CoyBeard/Mirobot-Frame-Building-Cell/CAD/Gantry System/Photos/With Monitor Setup.JPG

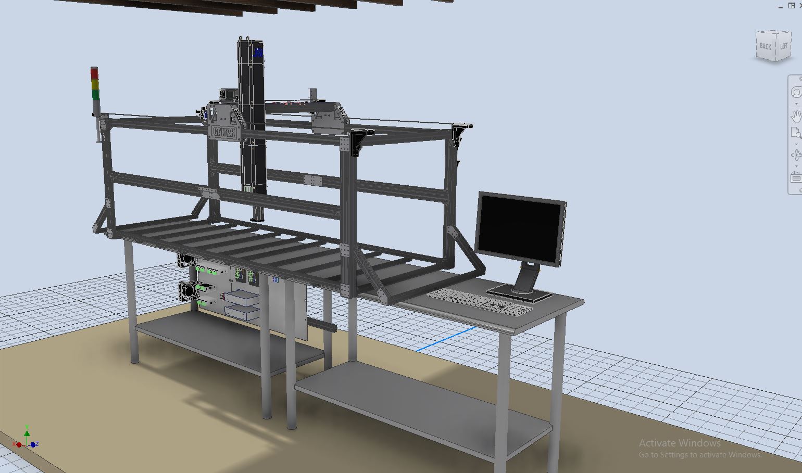
CAD/Gantry System/Photos/With Monitor Setup.JPG
