CoyBeard/Mirobot-Frame-Building-Cell/README.md

# Mirobot-Frame-Building-Cell

This is the posted CAD and Code from my video on youtube:
