CoyBeard/Mirobot-Frame-Building-Cell/CAD/Gantry System/Controllers/8x-relay-module-138x50-1.snapshot.8/8_Channel_Relay_Module_138_x_50_R2.png

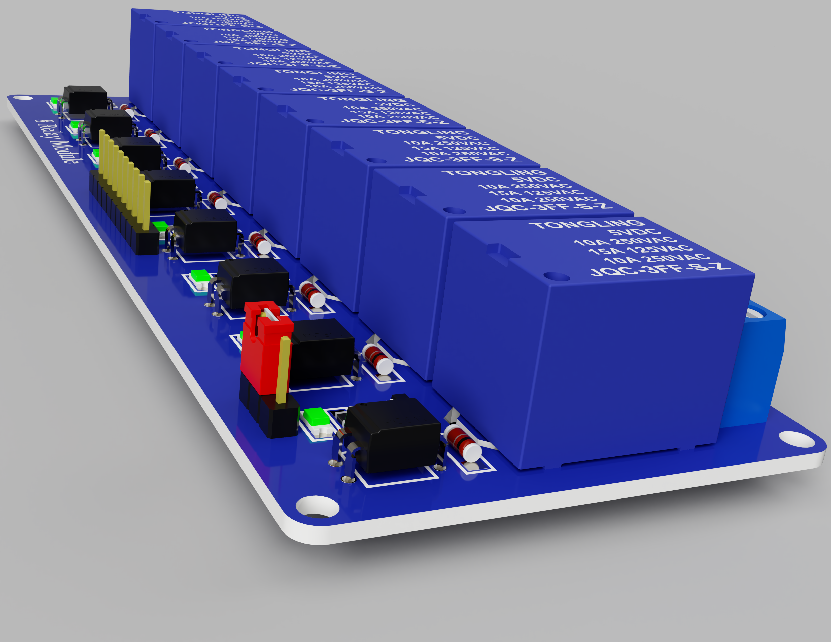
CAD/Gantry System/Controllers/8x-relay-module-138x50-1.snapshot.8/8_Channel_Relay_Module_138_x_50_R2.png
