CoyBeard/Mirobot-Frame-Building-Cell/CAD/Gantry System/DELL 1909Wf Monitor/RENDERY/2.png

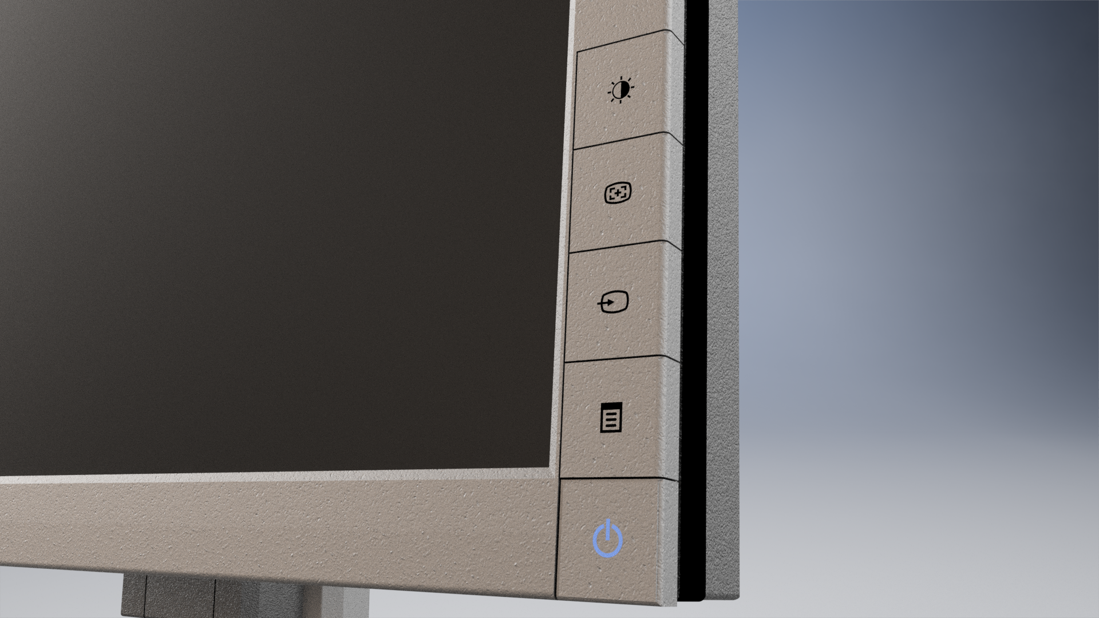
CAD/Gantry System/DELL 1909Wf Monitor/RENDERY/2.png
