CoyBeard/Mirobot-Frame-Building-Cell/CAD/Gantry System/Electrical/BTT Octopus V1.0 Pinout.png

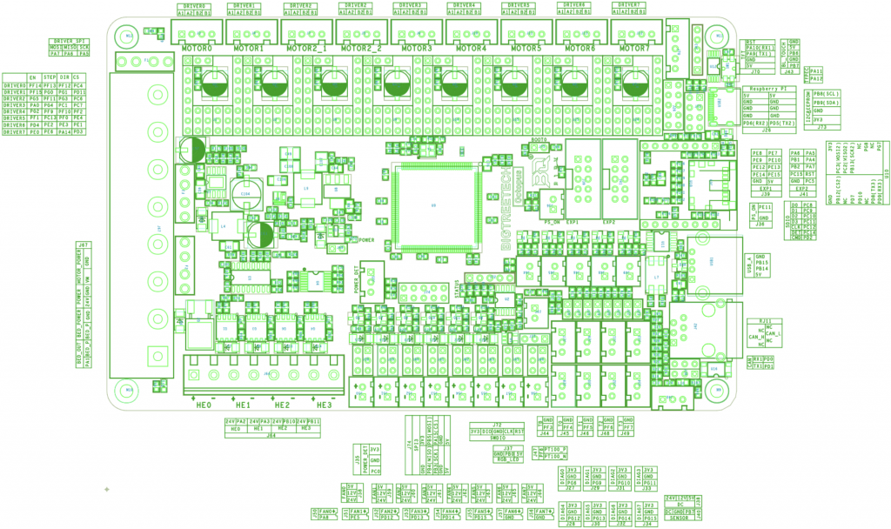
CAD/Gantry System/Electrical/BTT Octopus V1.0 Pinout.png
