CoyBeard/Mirobot-Frame-Building-Cell/CAD/Gantry System/Photos/Capture.JPG

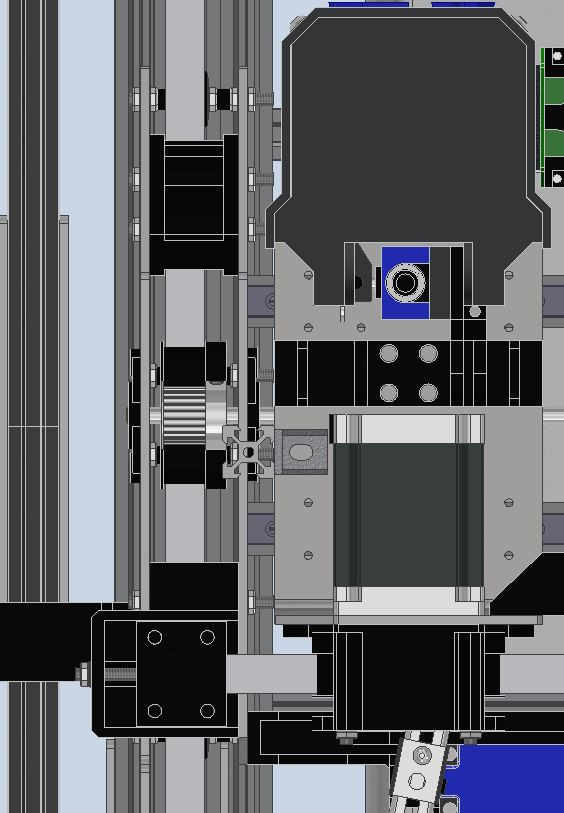
CAD/Gantry System/Photos/Capture.JPG
