CoyBeard/Mirobot-Frame-Building-Cell/CAD/Gantry System/Photos/Protoype.JPG

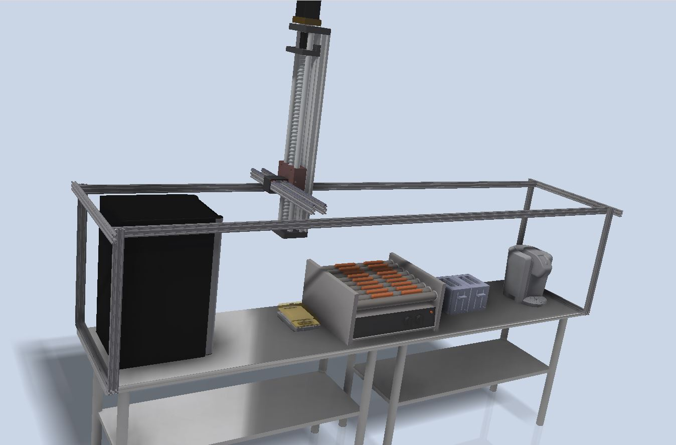
CAD/Gantry System/Photos/Protoype.JPG
