CoyBeard/Mirobot-Frame-Building-Cell/CAD/Gantry System/Photos/V1 CAD With Ray Tracing5.JPG

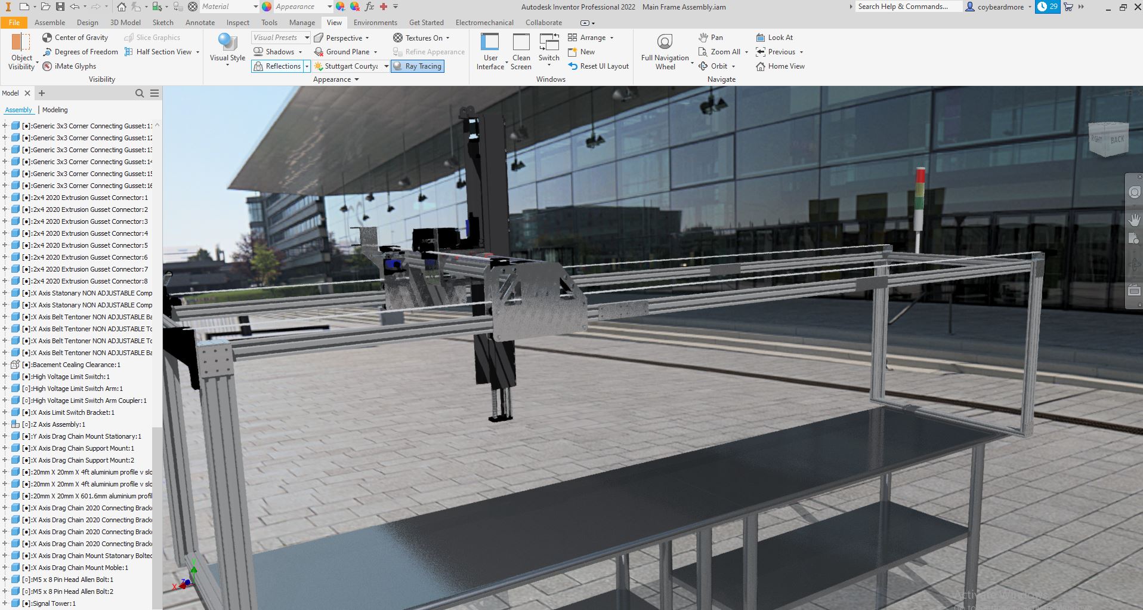
CAD/Gantry System/Photos/V1 CAD With Ray Tracing5.JPG
