CoyBeard/Mirobot-Frame-Building-Cell/CAD/Gantry System/Photos/V1 CAD With Ray Tracing6.JPG

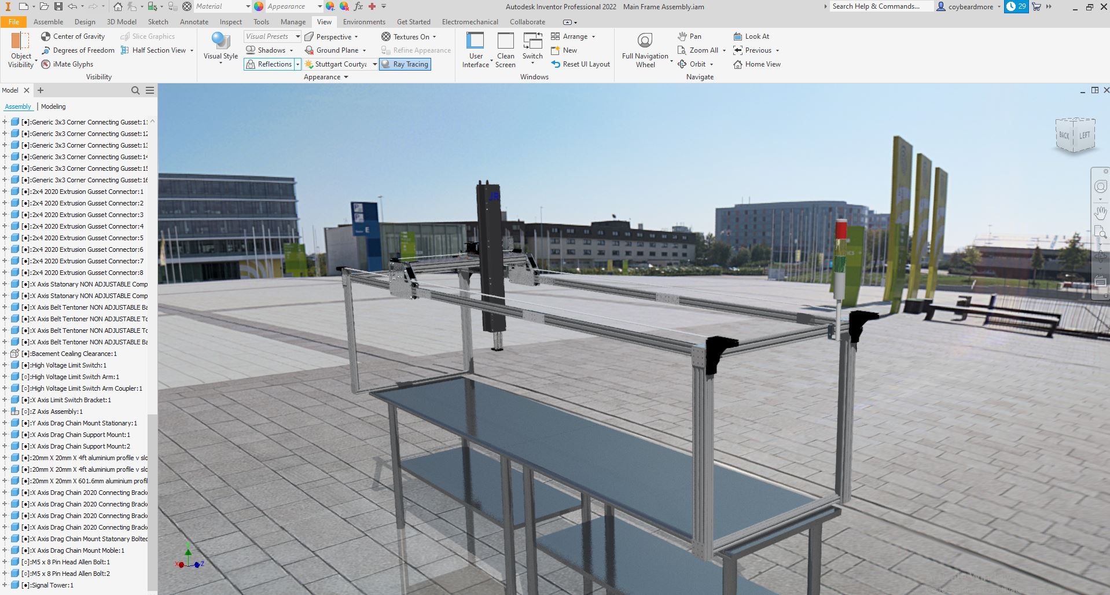
CAD/Gantry System/Photos/V1 CAD With Ray Tracing6.JPG
