CoyBeard/Mirobot-Frame-Building-Cell/CAD/Gantry System/Photos/V1 CAD With Ray Tracing.JPG

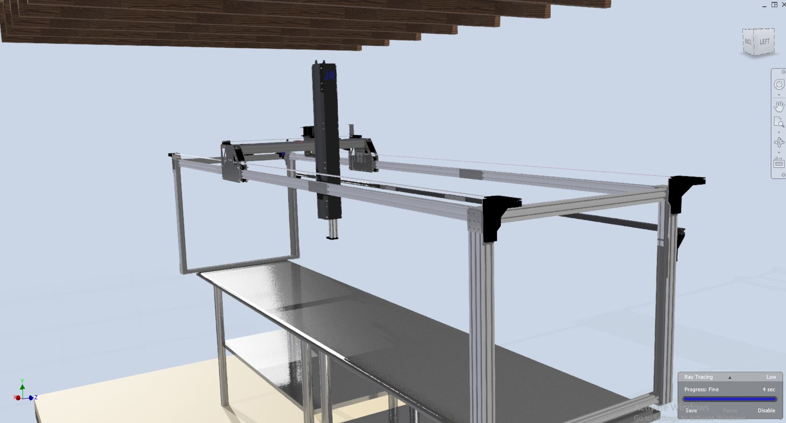
CAD/Gantry System/Photos/V1 CAD With Ray Tracing.JPG
