CoyBeard/Mirobot-Frame-Building-Cell/CAD/Gantry System/Photos/With Controll Pannel 2.JPG

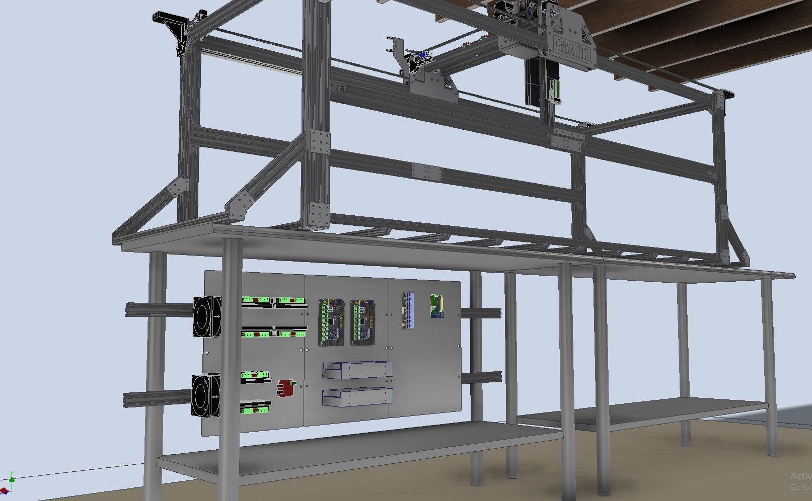
CAD/Gantry System/Photos/With Controll Pannel 2.JPG
