CoyBeard/Mirobot-Frame-Building-Cell/CAD/Gantry System/Photos/With Controll Pannel.JPG

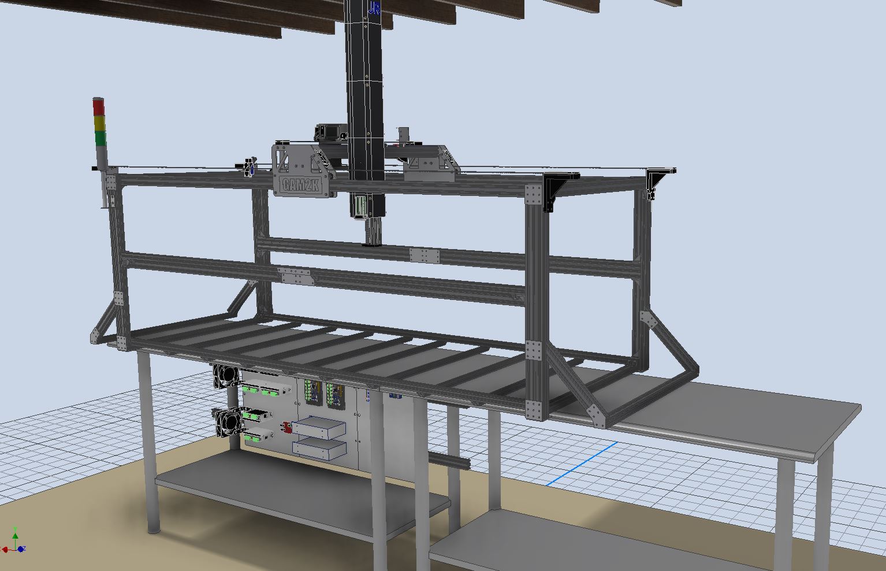
CAD/Gantry System/Photos/With Controll Pannel.JPG
