CoyBeard/Mirobot-Frame-Building-Cell/CAD/Gantry System/Photos/Z Axis Housing Dimentions.JPG

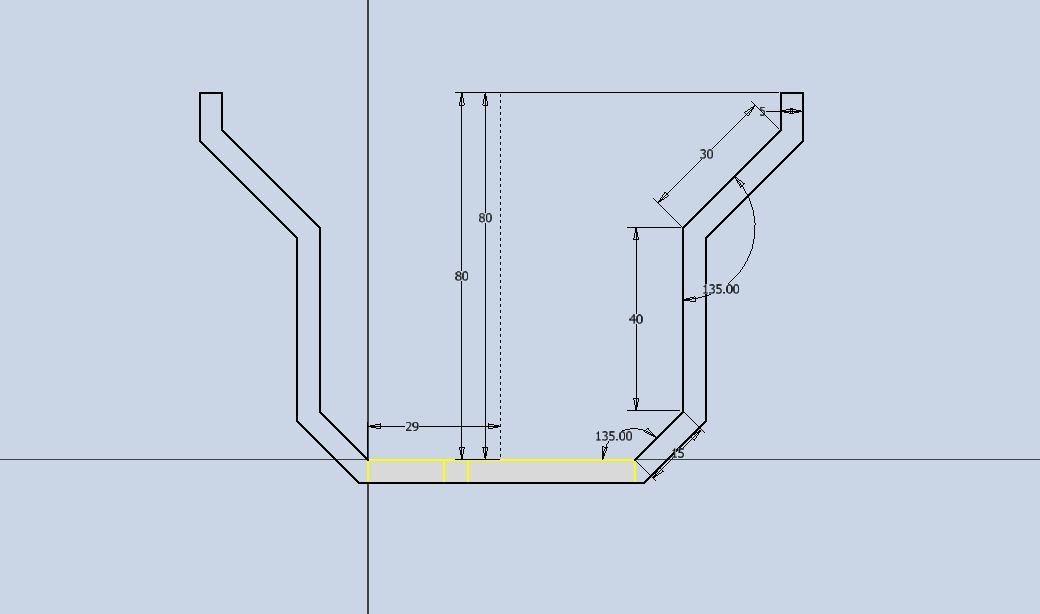
CAD/Gantry System/Photos/Z Axis Housing Dimentions.JPG
