CoyBeard/Mirobot-Frame-Building-Cell/CAD/Mirobot Rep Model/6 Axis Robot-ABB6650-3.jpg

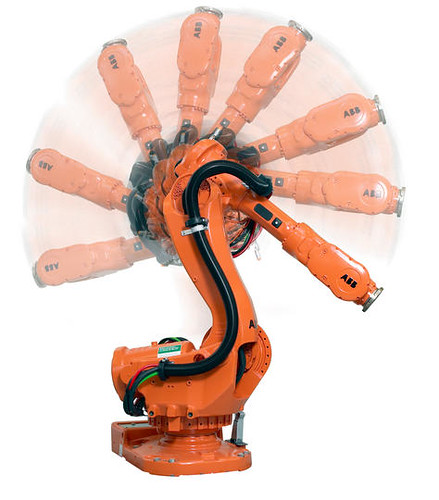
CAD/Mirobot Rep Model/6 Axis Robot-ABB6650-3.jpg
