CoyBeard/Mirobot-Frame-Building-Cell/CAD/Mirobot Rep Model/6 Axis Robot-ABB6650-4.jpg

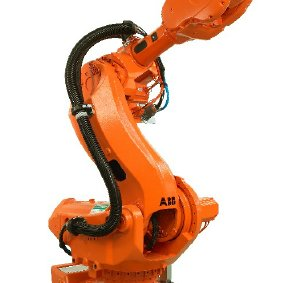
CAD/Mirobot Rep Model/6 Axis Robot-ABB6650-4.jpg
