CoyBeard/Mirobot-Frame-Building-Cell/Code/VSCode/Demo Program UI.JPG

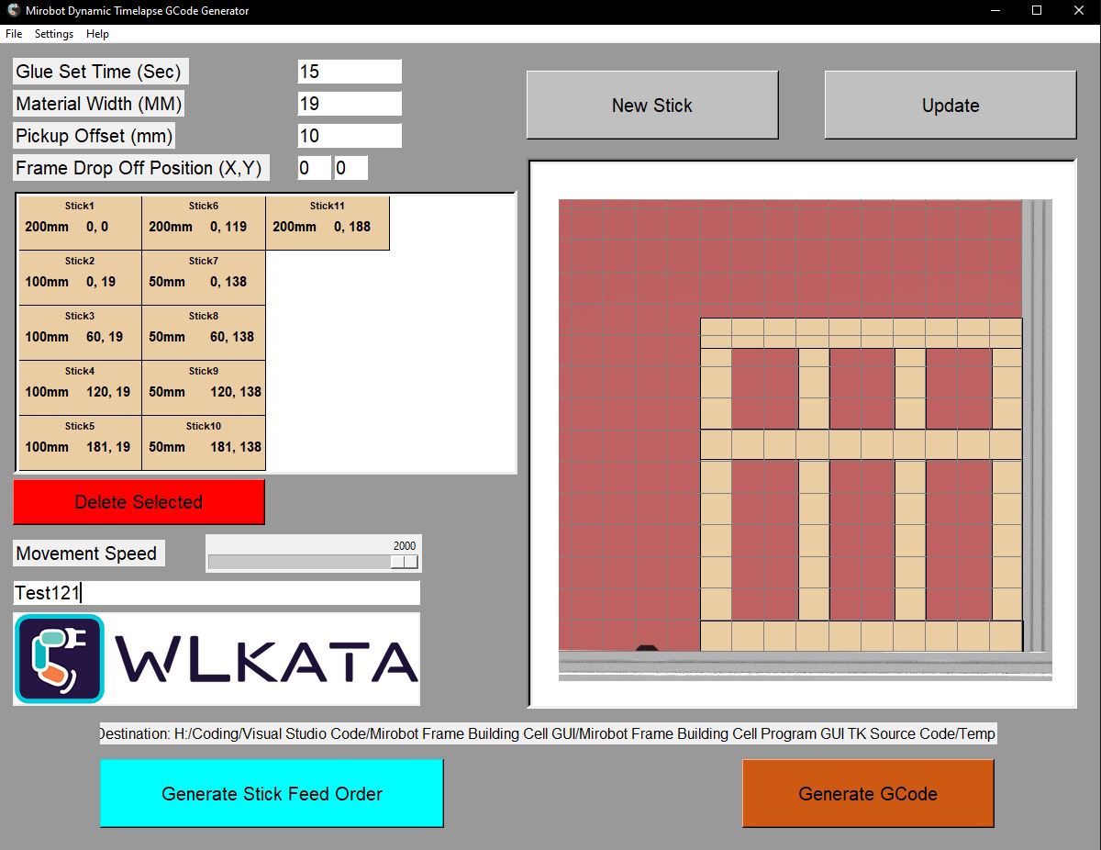
Code/VSCode/Demo Program UI.JPG
