CoyBeard/Mirobot-Frame-Building-Cell/CAD/Gantry System/Machined Parts/V1 Machined Parts List.txt

1x  4in x 6in Steel Rectangular Tubing 4in long Machined
1x  X Axis Belt Motor Inside Frame Machined
1x  X Axis Belt V Wheel and Motor Frame Machined
1x  X Axis Belt V Wheel Frame Machined
1x  X Axis Belt V Wheel LEFT Outside Frame Machined
1x  X Axis Belt V Wheel RIGHT Outside Frame Machined
2x  2x4 2020 Extrusion Gusset Connector
2x  X Axis Statonary Composite Belt Holder
2x  X Axis Statonary NON ADJUSTABLE Composite Belt Holder
4x  X Axis Drag Chain 2020 Connecting Bracket
16x Generic 3x3 Corner Connecting Gusset
