CoyBeard/Mirobot-Frame-Building-Cell/Code/VSCode/Mirobot Frame Building Cell Program GUI TK Source Code V1.1/Temp Files/TestTw Stick Feed Order.txt

;File generated by Mirobot Frame Building Cell GUI
;V1.0.0
;Date Generated: 2023-01-07 21:08:34.981438

Universal Information:
Material Width: 19
Build Platform Width: 280mm
Build Platform Heighth: 275mm

Stick Feed Order:
1.  Stick1, Length: 200mm

2.  Right Wall, Length: 100mm

3.  Stick3, Length: 100mm

4.  Stick4, Length: 200mm

End
