CoyBeard/Mirobot-Frame-Building-Cell/CAD/Gantry System/Machined Parts/Machined Parts Tracking.pdf

| GAM2K Machined Parts List

PROJECT TITLE

GAM2K | COMPANY NAME JR Automation
PROJECT MANAGER | Coy Beardmore DATE 10/30/21
PROJECT DETAILS | COST/HOURS
STATUS | PRIORITY | START DATE | END DATE | DURATION | ASSIGNEE | DESCRIPTION | FIXED COST | HOURS

## 1x 4in x 6in Steel Rectangular Tubing 4in long

3D Modeled | | 10/11/21 | 10/30/21 | 19 | CJB | Create CAD Model of Part
CAM Generated | | | | | CJB | Generate GCode for CNC Mill
Machined | | | | | CJB | Part Manufactured
Installed | | | | | CJB | Part Installed

## 1x X Axis Belt Motor Inside Frame

3D Modeled | | 10/11/21 | 10/30/21 | 19 | CJB | Create CAD Model of Part
CAM Generated | | | | | CJB | Generate GCode for CNC Mill
Machined | | | | | CJB | Part Manufactured
Installed | | | | | CJB | Part Installed

## 1x X Axis Belt V Wheel and Motor Frame

3D Modeled | | 10/11/21 | 10/30/21 | 19 | CJB | Create CAD Model of Part
CAM Generated | | | | | CJB | Generate GCode for CNC Mill
Machined | | | | | CJB | Part Manufactured
Installed | | | | | CJB | Part Installed

## 1x X Axis Belt V Wheel Frame

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

## 1x X Axis Belt V Wheel LEFT Outside Frame

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

STATUS KEY | PRIORITY KEY
3D Modeled | Low
CAM Generated | Medium
Machined | High

Installed

## 1x X Axis Belt V Wheel RIGHT Outside Frame

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

## 2x 2x4 2020 Extrusion Gusset Connector

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

## 2x X Axis Statonary Composite Belt Holder

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

## 2x X Axis Statonary NON ADJUSTABLE Composite Belt Holder

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

## 4x X Axis Drag Chain 2020 Connecting Bracket

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

## 16x Generic 3x3 Corner Connecting Gusset

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
