CoyBeard/Mirobot-Frame-Building-Cell/CAD/Gantry System/3D Printed Parts/Printed Parts Tracking.pdf

| GAM2K 3D PRINTED PARTS LIST

PROJECT TITLE

GAM2K | COMPANY NAME JR Automation
PROJECT MANAGER | Coy Beardmore DATE 10/30/21
| | | | PROJECT DETAILS | | | | COST/HOURS
STATUS | PRIORITY | START DATE | END DATE | DURATION | ASSIGNEE | DESCRIPTION | FIXED COST | Printed | Time Elapsed

## BK1XO1 X Axis Pully Support

Modeled | | 10/11/21 | 10/30/21 | 19 | CJB | Create CAD Model of Part
Sliced | 10/30/21 | 10/30/21 | 0 | CJB | Slice Model into GCode
Printed | | 10/30/21 | | | CJB | 3D Print Model to Spec
Installed | CJB | Install Part

## BK1XO1 Y Axis Limit Switch and Drag Chain Mount

Modeled | | 10/11/21 | 10/30/21 | 19 | CJB | Create CAD Model of Part
Sliced 10/30/21 10/30/21 0 Printed 10/30/21 Installed | CJB CJB CJB | Slice Model into GCode 3D Print Model to Spec Install Part
| BK1XO3 Z Axis Cover Frame
Modeled | 10/11/21 | 10/30/21 | 19 | CJB | Create CAD Model of Part
Sliced | 10/30/21 | 10/30/21 | 0 | CJB | Slice Model into GCode
Printed | 10/30/21 | | | CJB | 3D Print Model to Spec
Installed | | | | CJB | Install Part

## BK2XO2 X Axis Belt Tentoner Base and Mirrored

Modeled | 10/11/21 | 10/30/21 | 19 | CJB | Create CAD Model of Part
Sliced | 10/30/21 | 10/30/21 | 0 | CJB | Slice Model into GCode
Printed | 10/30/21 | | | CJB | 3D Print Model to Spec
Installed | | | | CJB | Install Part

## BK2XO2 X Axis Belt Tentoner Stationary Base and Mirrored

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

STATUS KEY | PRIORITY KEY
Modeled | Low
Sliced | Medium
Printed | High

Installed

## BK2XO2 X Axis Drag Chain Support Mount

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

## BK5XO5 GAM2K Parts 02

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

## BK6XO6 8mm ID 15mm Deep Idler Pully

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

## BK8XO8 GAM2K Parts 03

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

## BK9XO9 GAM2K Parts 01

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

## BK24XO24 Spacers

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

## BL1XO1 JR Logo Text

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

## GY1XO1 Z Axis Cover Bottom

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

## GY1XO1 Z Axis Cover Top

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

## GY1XO1 Z Axis Frame Top

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

## GY1XO3 Z Axis Cover

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
