CoyBeard/Mirobot-Frame-Building-Cell/CAD/Conveyor Belt/Conveyor Belt Assembly.stp

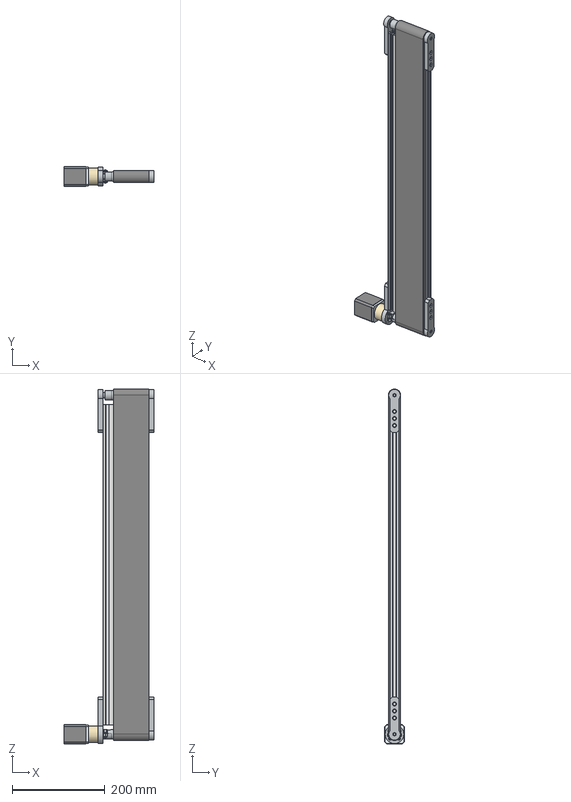
[picture p29: CAD file, 2023-06-10]
CAD/Conveyor Belt/Conveyor Belt Assembly.stp
193.3 x 42.0 x 764.4 mm
20100 640mm Aluminum Extrusion
Roller Bracket x 3
5mm ID 8mm OD 2.5mm Deep Roller Bearing x 3
Roller Bracket Driven
M5 120mm Rod
M5 60mm Rod
M5 5mm Spacer x 3
Driven Pully
Driven Pully Coupler Top
M4 x 12 Socket Head Bolt x 2
M4 Nut x 2
Idler Pully
Belt 5ft x 3in
Nema 17 5TO1 Geared Stepper Motor
