CoyBeard/Mirobot-Frame-Building-Cell/CAD/Glue Extruder/3ml/3ml Glue Extruder Assembly.stp

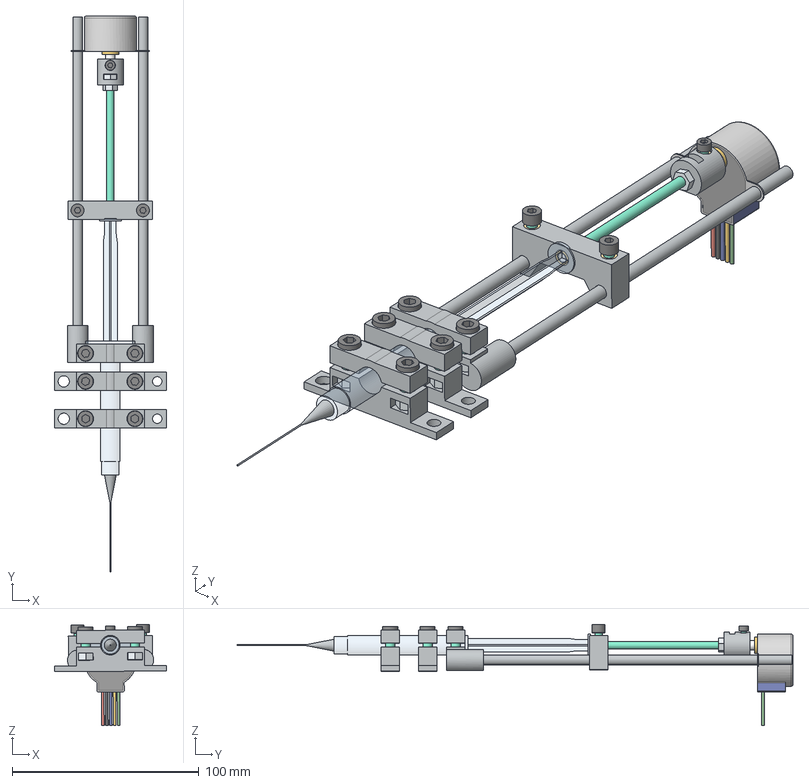
[picture p30: CAD file, 2023-06-10]
CAD/Glue Extruder/3ml/3ml Glue Extruder Assembly.stp
60.0 x 297.5 x 54.1 mm
3ml Main Clamp Top x 3
3ml Seringe Press
3ml Seringe Main
M3 6mm Socket Head Bolt
3ml Main Clamp Bottom
M5 Nut x 6
Needle
M5 12mm Socket Head Bolt x 6
M3 5mm OD 4mm Deep Threaded Insert
5V Stepper Motor
5V Stepper Motor Coupler to M4 Threaded Rod
Stationary Thread Holding Block
M4 6mm OD 10mm Deep Threaded Insert x 3
M4 12mm Socket Head Bolt x 2
3ml Mount Clamp x 2
M4 Nut x 2
M4 80mm Threaded Rod
M5 175mm Rod x 2
