CoyBeard/Mirobot-Frame-Building-Cell/CAD/Glue Extruder/5ml/5ml Glue Extruder Assembly.stp

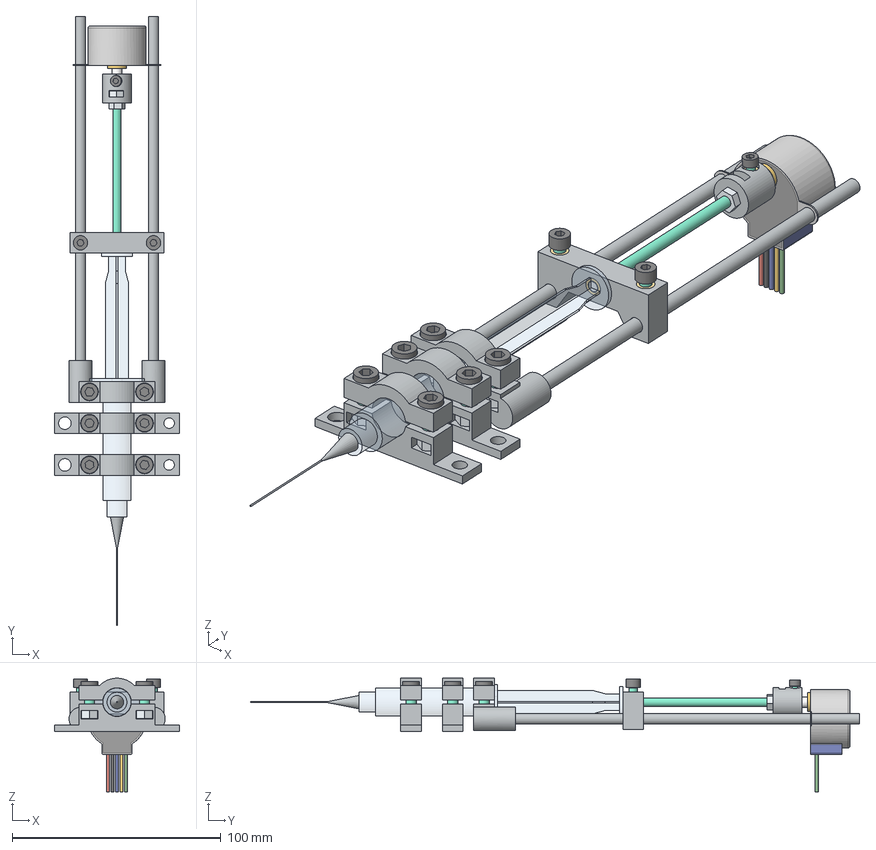
[picture p31: CAD file, 2023-06-10]
CAD/Glue Extruder/5ml/5ml Glue Extruder Assembly.stp
60.0 x 292.0 x 54.5 mm
5ml Seringe Press
5ml Seringe Main
5ml Main Clamp Bottom
5ml Mount Clamp x 2
M5 Nut x 6
5ml Main Clamp Top x 3
M5 12mm Socket Head Bolt x 6
Needle
M5 175mm Rod x 2
Stationary Thread Holding Block
M4 6mm OD 10mm Deep Threaded Insert x 3
M4 12mm Socket Head Bolt x 2
5V Stepper Motor
M4 80mm Threaded Rod
5V Stepper Motor Coupler to M4 Threaded Rod
M4 Nut x 2
M3 5mm OD 4mm Deep Threaded Insert
M3 6mm Socket Head Bolt
