CoyBeard/Mirobot-Frame-Building-Cell/CAD/Gantry System/3D Printed Parts/Raspberry Pi 4B Case/Pi4caseTop.stl

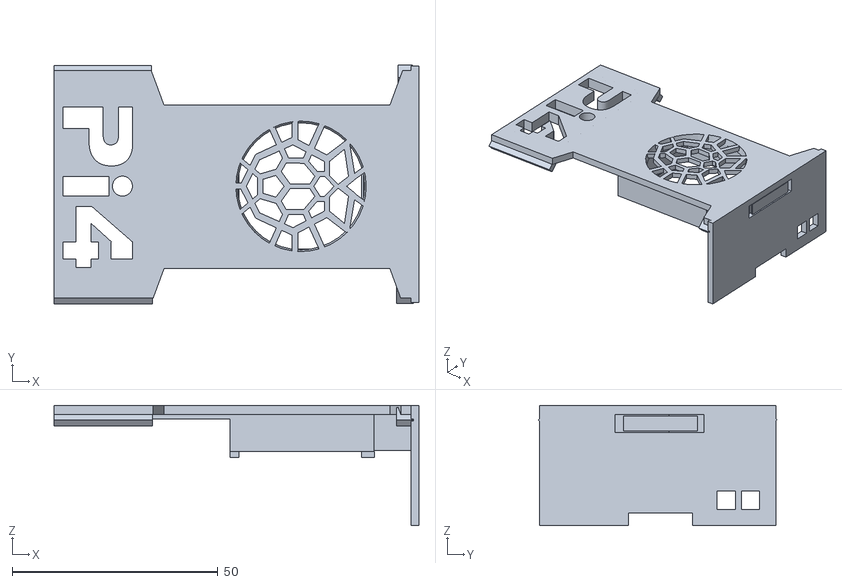
[picture p32: CAD file, 2023-06-10]
CAD/Gantry System/3D Printed Parts/Raspberry Pi 4B Case/Pi4caseTop.stl
88.8 x 58.1 x 29.2
