CoyBeard/Mirobot-Frame-Building-Cell/CAD/Gantry System/3D Printed Parts/STLs/V1/Black PLA/1x  Z Axis Cover Frame Bottom.stl

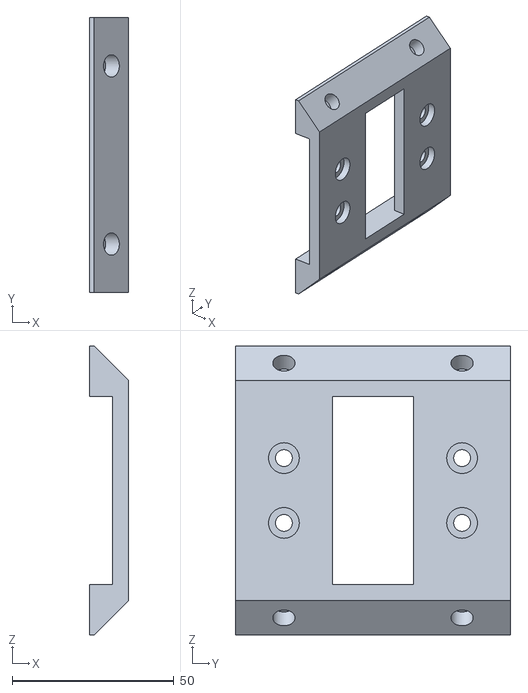
[picture p33: CAD file, 2023-06-10]
CAD/Gantry System/3D Printed Parts/STLs/V1/Black PLA/1x Z Axis Cover Frame Bottom.stl
12.1 x 85.0 x 89.2
