CoyBeard/Mirobot-Frame-Building-Cell/CAD/Gantry System/Drivers/DM542/DM542.STEP

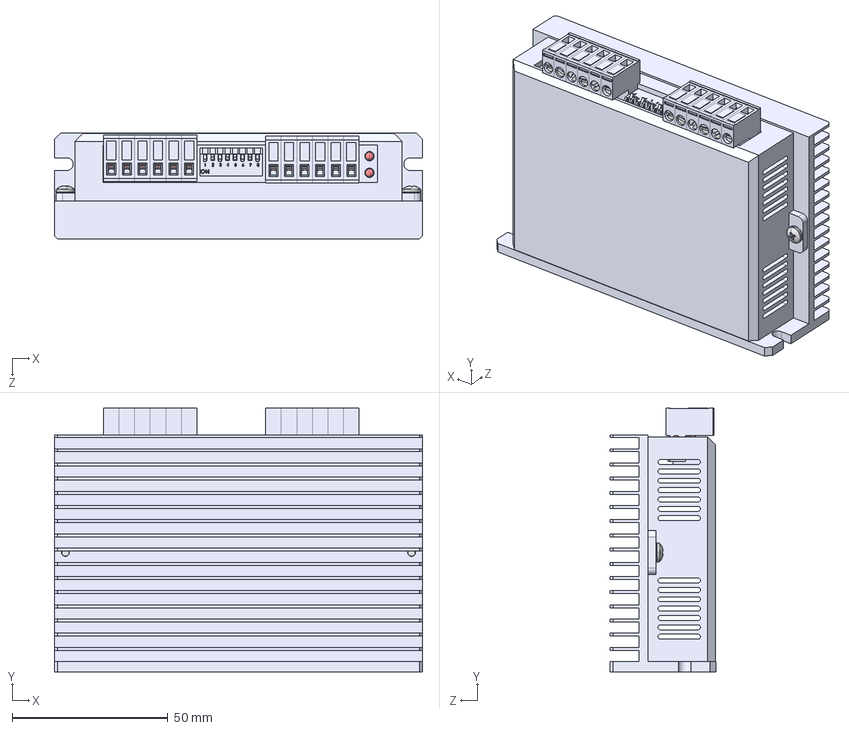
[picture p34: CAD file, 2023-06-10]
CAD/Gantry System/Drivers/DM542/DM542.STEP
118.0 x 84.6 x 34.0 mm
散熱片
外殼
Pan Head M3x5_96741A118 x 2
端子(1P) x 12
ｩTｩwﾁｳｵｷ x 12
緊迫 x 12
LED x 2
DIP Switch
Switch x 8
