CoyBeard/Mirobot-Frame-Building-Cell/CAD/Gantry System/Machined Parts/Y Axis Frame HAAS Files/4in x 6in Steel Rectangular Tubing 4in long Machined.stp

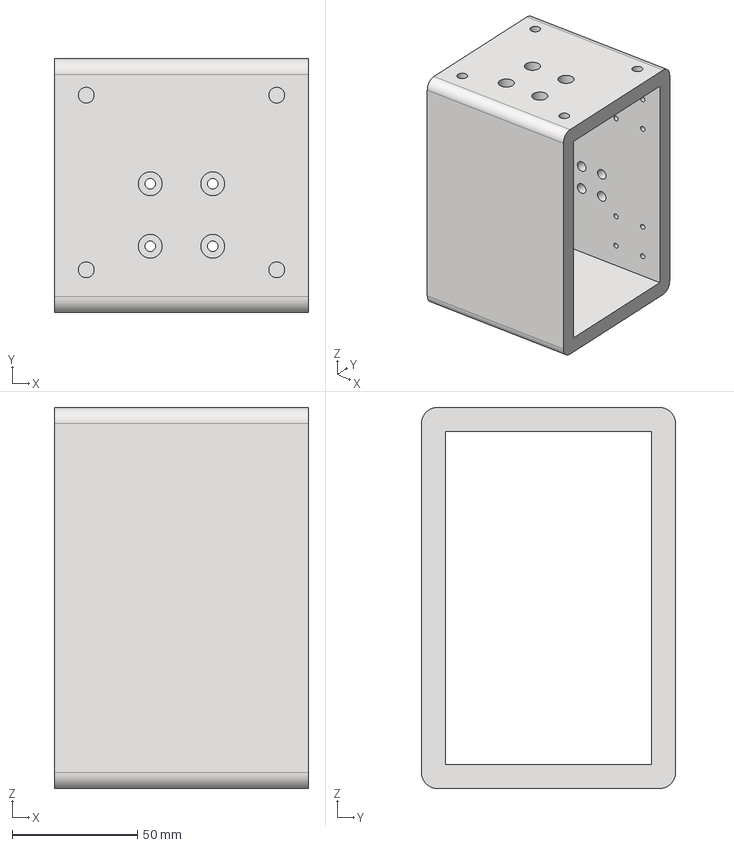
[picture p35: CAD file, 2023-06-10]
CAD/Gantry System/Machined Parts/Y Axis Frame HAAS Files/4in x 6in Steel Rectangular Tubing 4in long Machined.stp
101.6 x 101.6 x 152.4 mm
