CoyBeard/Mirobot-Frame-Building-Cell/CAD/Gantry System/Power Supplys/24V15A power supply.stp

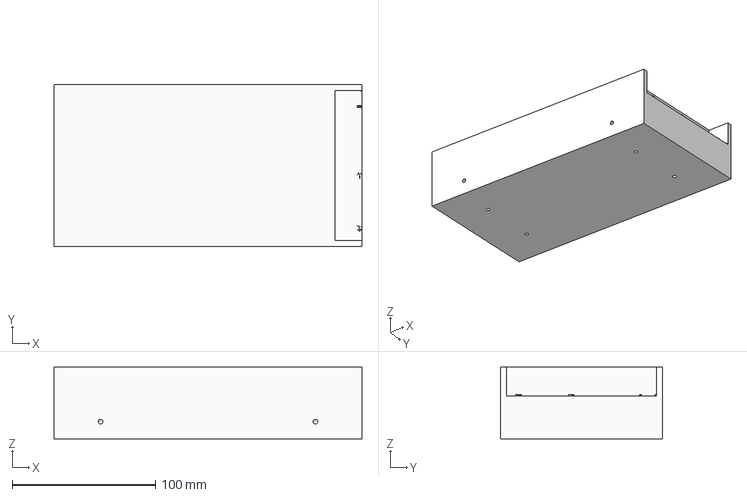
[picture p36: CAD file, 2023-06-10]
CAD/Gantry System/Power Supplys/24V15A power supply.stp
215.0 x 113.0 x 50.0 mm
