CoyBeard/Mirobot-Frame-Building-Cell/CAD/Mirobot Rep Model/Sliding Rail/Floor Mounting Plate.stp

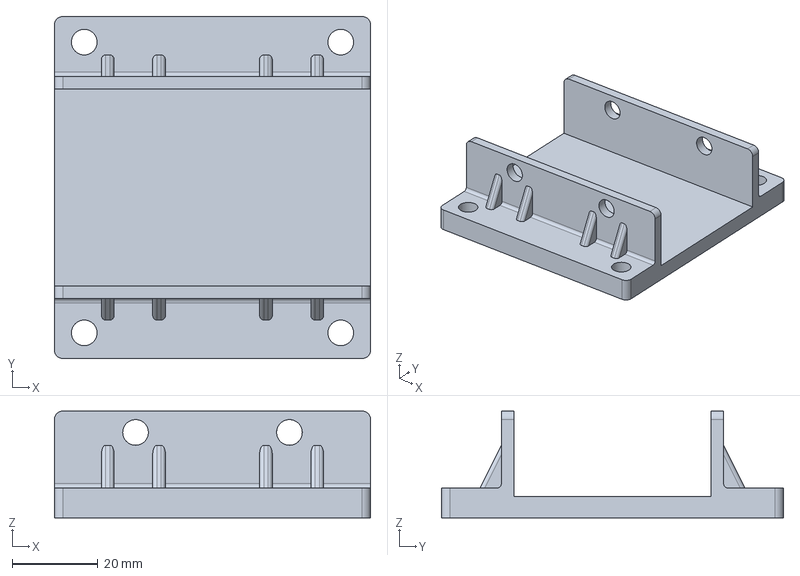
[picture p37: CAD file, 2023-06-10]
CAD/Mirobot Rep Model/Sliding Rail/Floor Mounting Plate.stp
74.0 x 80.0 x 25.0 mm
