CoyBeard/Mirobot-Frame-Building-Cell/CAD/Gantry System/3D Printed Parts/Raspberry Pi 4B Case/Pi4caseBottom-nosupports.stl

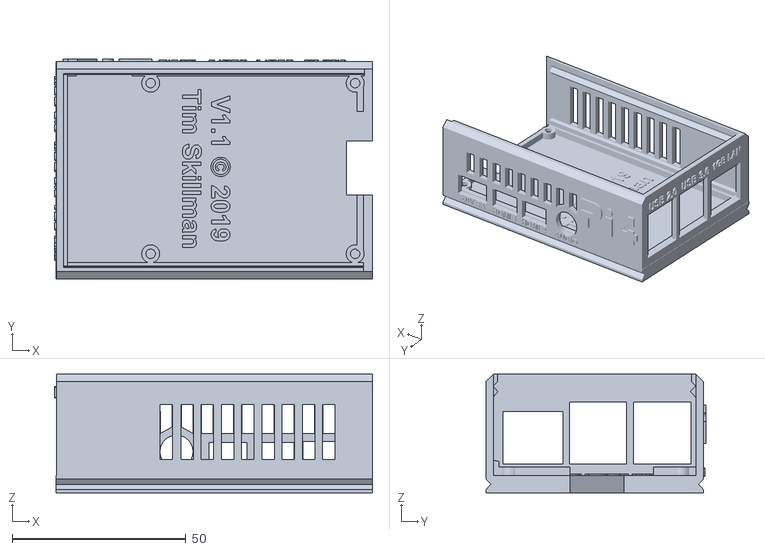
[picture p38: CAD file, 2023-06-10]
CAD/Gantry System/3D Printed Parts/Raspberry Pi 4B Case/Pi4caseBottom-nosupports.stl
91.6 x 63.4 x 34.3
