CoyBeard/Mirobot-Frame-Building-Cell/CAD/Gantry System/3D Printed Parts/STLs/V1/Black PLA/1x  Y Axis Belt Adjustable Grip Plate.stl

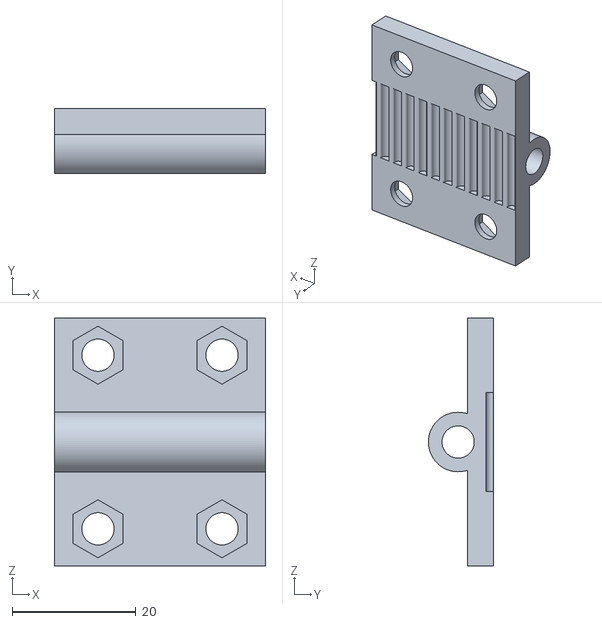
[picture p39: CAD file, 2023-06-10]
CAD/Gantry System/3D Printed Parts/STLs/V1/Black PLA/1x Y Axis Belt Adjustable Grip Plate.stl
34.1 x 10.5 x 40.0
