CoyBeard/Mirobot-Frame-Building-Cell/CAD/Gantry System/3D Printed Parts/STLs/V1/Black PLA/1x  X Axis Drag Chain Mount Moble.stl

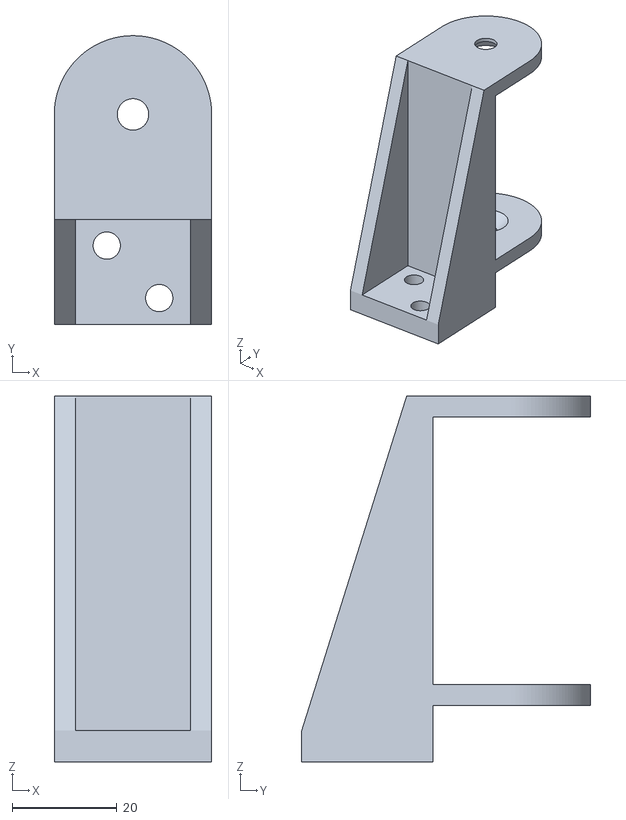
[picture p40: CAD file, 2023-06-10]
CAD/Gantry System/3D Printed Parts/STLs/V1/Black PLA/1x X Axis Drag Chain Mount Moble.stl
30.0 x 55.0 x 69.8
