CoyBeard/Mirobot-Frame-Building-Cell/CAD/Gantry System/Controllers/raspberry-pi-4-model-b-1.snapshot.3/2X USB2.0 PORTS, RPi4ModelB.SLDPRT

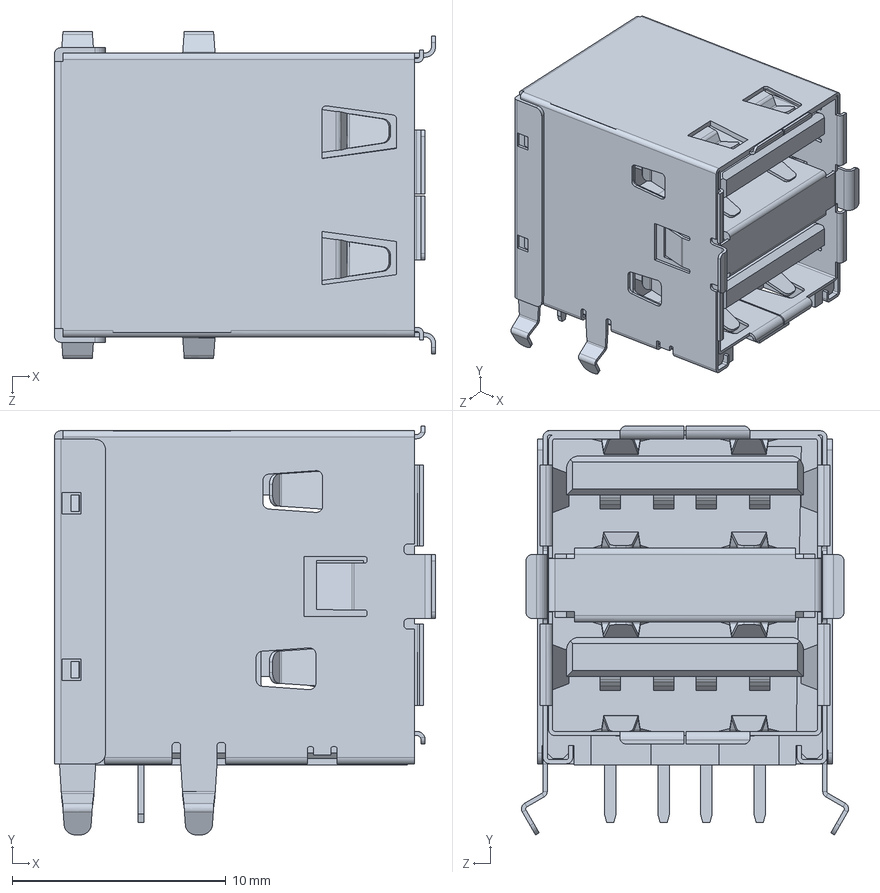
[picture p41: CAD file, 2023-06-10]
CAD/Gantry System/Controllers/raspberry-pi-4-model-b-1.snapshot.3/2X USB2.0 PORTS, RPi4ModelB.SLDPRT
17.9 x 19.2 x 15.3 mm
