CoyBeard/Mirobot-Frame-Building-Cell/CAD/Gantry System/3D Printed Parts/Raspberry Pi 4B Case/Pi4caseBottomB.stl

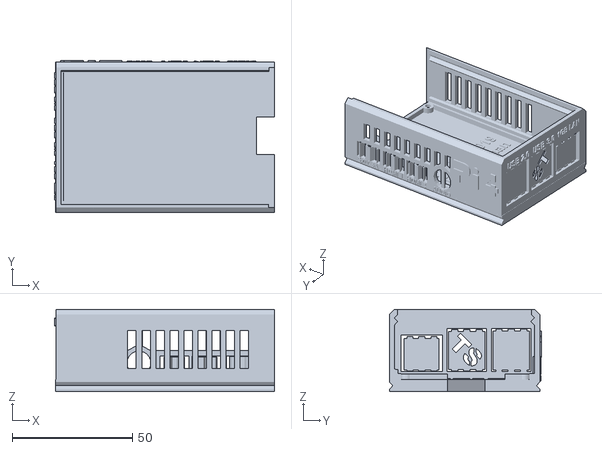
[picture p42: CAD file, 2023-06-10]
CAD/Gantry System/3D Printed Parts/Raspberry Pi 4B Case/Pi4caseBottomB.stl
91.6 x 63.4 x 34.3
