CoyBeard/Mirobot-Frame-Building-Cell/CAD/Gantry System/3D Printed Parts/STLs/V1/Black PLA/2x  X Axis Drag Chain Support Mount.stl

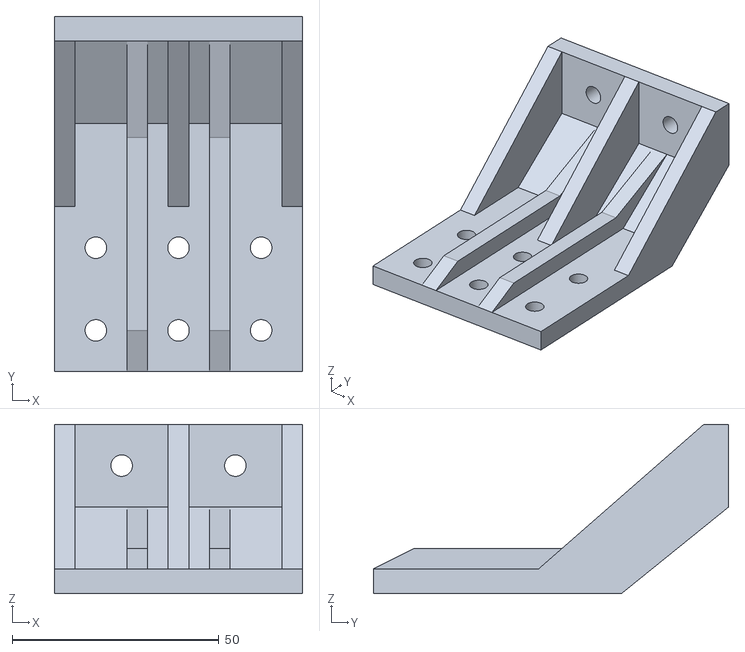
[picture p43: CAD file, 2023-06-10]
CAD/Gantry System/3D Printed Parts/STLs/V1/Black PLA/2x X Axis Drag Chain Support Mount.stl
60.0 x 86.0 x 41.0
