CoyBeard/Mirobot-Frame-Building-Cell/CAD/Gantry System/Controllers/raspberry-pi-4-model-b-1.snapshot.3/2X USB3.0 PORTS, RPi4ModelB.SLDPRT

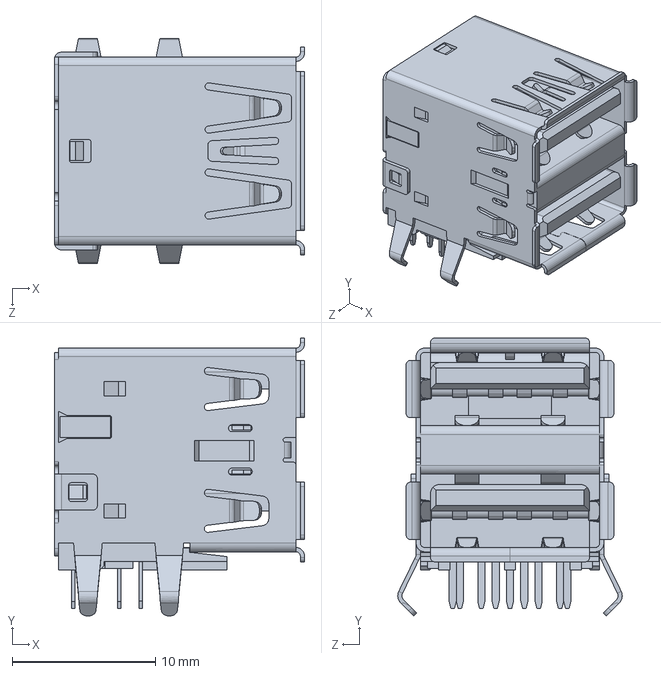
[picture p44: CAD file, 2023-06-10]
CAD/Gantry System/Controllers/raspberry-pi-4-model-b-1.snapshot.3/2X USB3.0 PORTS, RPi4ModelB.SLDPRT
17.5 x 19.4 x 15.7 mm
