CoyBeard/Mirobot-Frame-Building-Cell/CAD/Gantry System/3D Printed Parts/STLs/V1/Black PLA/1x  Y Axis Belt Adjustable and Plate Spacer.stl

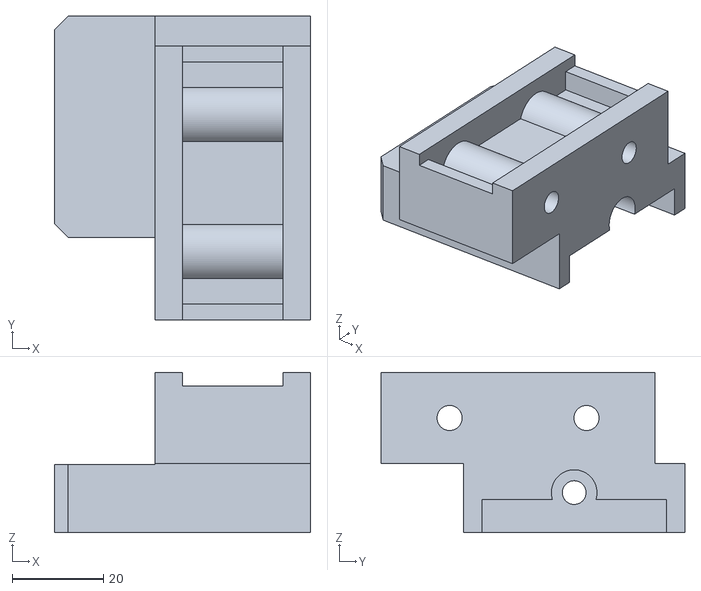
[picture p45: CAD file, 2023-06-10]
CAD/Gantry System/3D Printed Parts/STLs/V1/Black PLA/1x Y Axis Belt Adjustable and Plate Spacer.stl
56.1 x 66.6 x 35.1
