CoyBeard/Mirobot-Frame-Building-Cell/CAD/Gantry System/Controllers/raspberry-pi-4-model-b-1.snapshot.3/Female Micro HDMI Connector, RPi4ModelB.SLDPRT

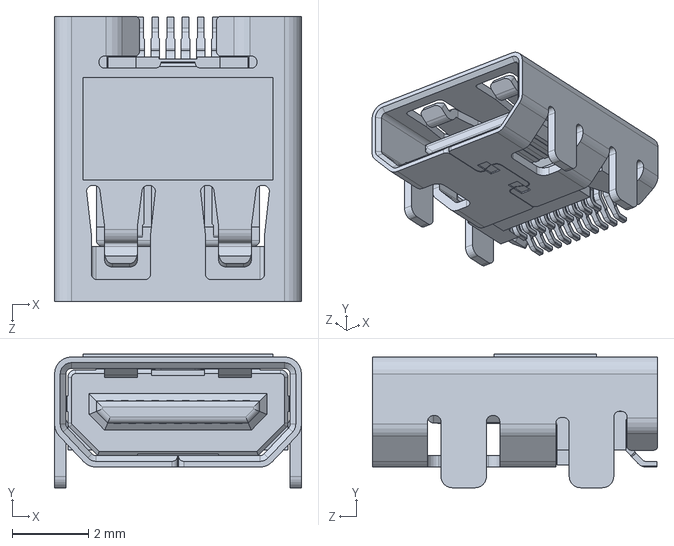
[picture p46: CAD file, 2023-06-10]
CAD/Gantry System/Controllers/raspberry-pi-4-model-b-1.snapshot.3/Female Micro HDMI Connector, RPi4ModelB.SLDPRT
6.50 x 3.52 x 7.50 mm
