CoyBeard/Mirobot-Frame-Building-Cell/CAD/Gantry System/3D Printed Parts/Raspberry Pi 4B Case/Pi4wallMount.stl

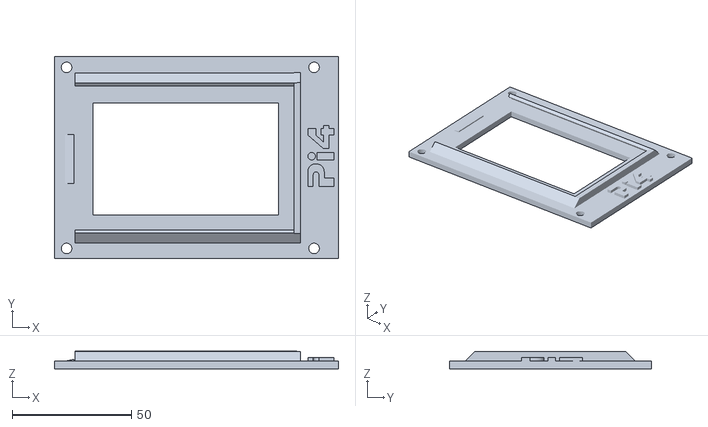
[picture p47: CAD file, 2023-06-10]
CAD/Gantry System/3D Printed Parts/Raspberry Pi 4B Case/Pi4wallMount.stl
118.9 x 84.4 x 7.35
