CoyBeard/Mirobot-Frame-Building-Cell/CAD/Gantry System/3D Printed Parts/STLs/V1/Black PLA/1x  Z Axis Limt Adjustable Trigger.stl

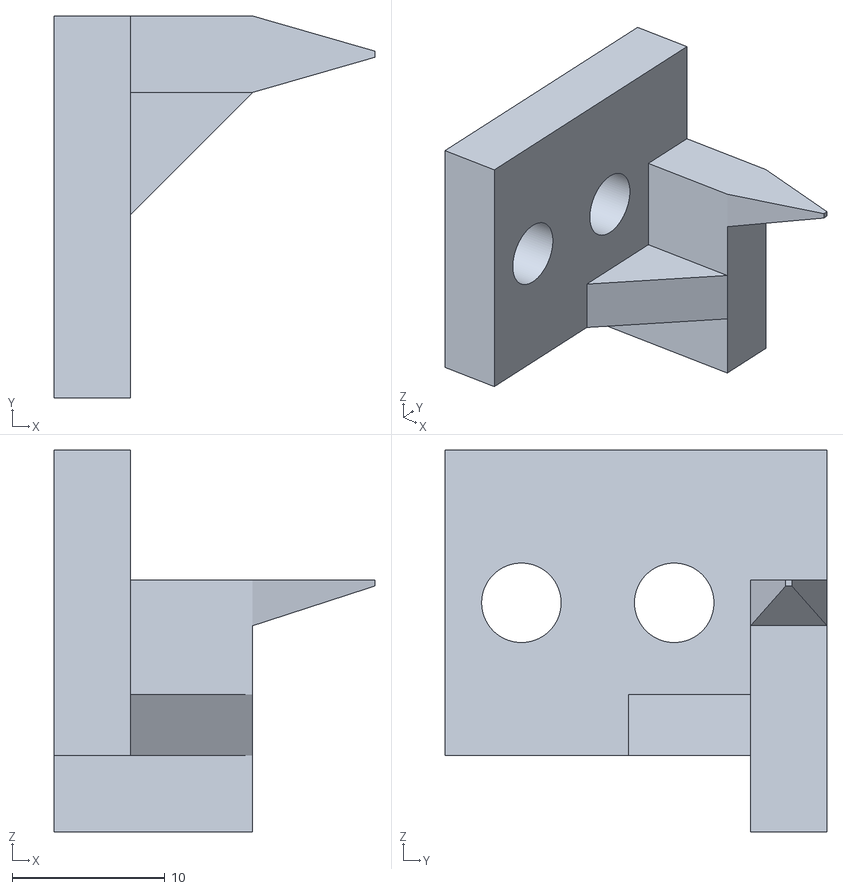
[picture p48: CAD file, 2023-06-10]
CAD/Gantry System/3D Printed Parts/STLs/V1/Black PLA/1x Z Axis Limt Adjustable Trigger.stl
21.0 x 25.0 x 25.0
