CoyBeard/Mirobot-Frame-Building-Cell/CAD/Gantry System/3D Printed Parts/STLs/V1/Black PLA/2x  X Axis Belt and V Wheel Plate Spacer.stl

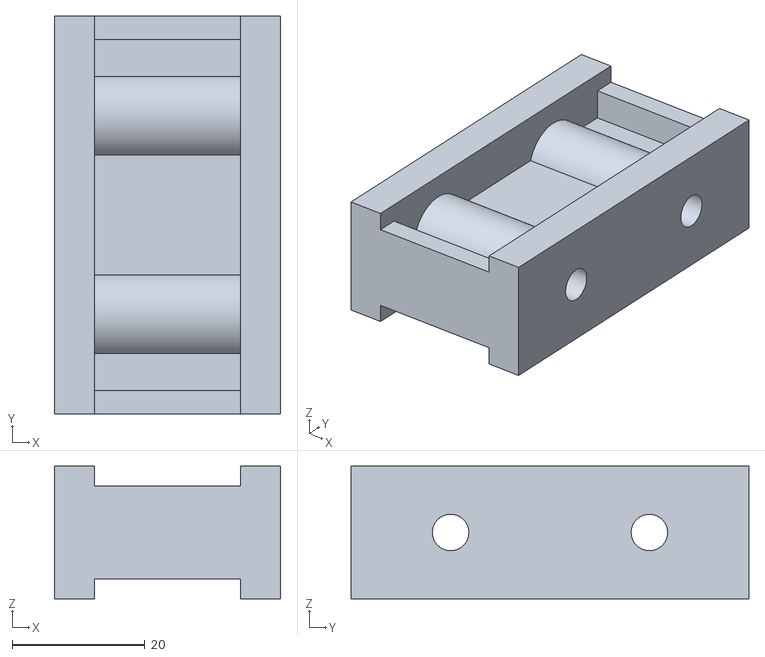
[picture p49: CAD file, 2023-06-10]
CAD/Gantry System/3D Printed Parts/STLs/V1/Black PLA/2x X Axis Belt and V Wheel Plate Spacer.stl
34.1 x 60.0 x 20.0
