CoyBeard/Mirobot-Frame-Building-Cell/CAD/Gantry System/3D Printed Parts/STLs/V1/Black PLA/1x  Y Axis Belt Adjustable Top.stl

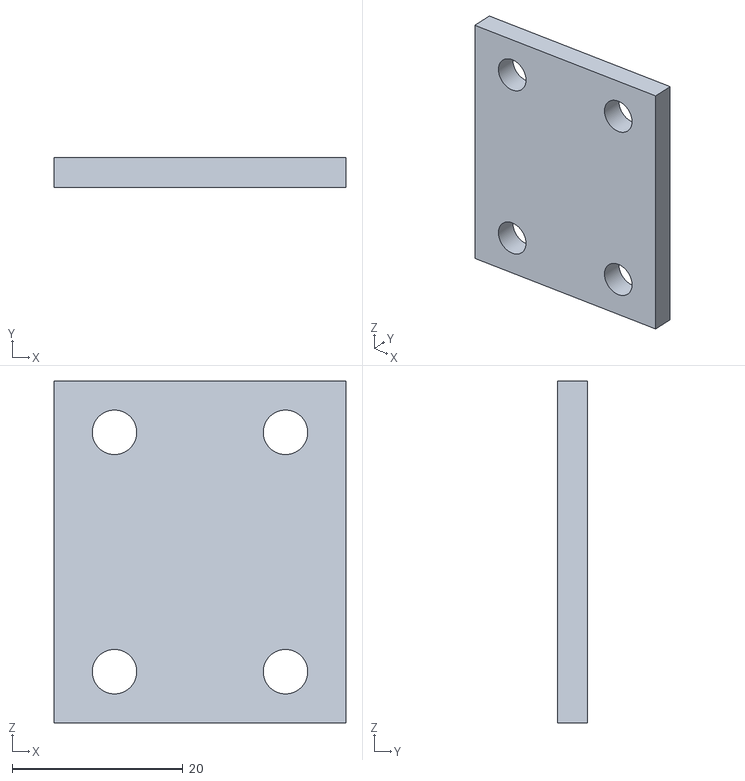
[picture p51: CAD file, 2023-06-10]
CAD/Gantry System/3D Printed Parts/STLs/V1/Black PLA/1x Y Axis Belt Adjustable Top.stl
34.1 x 3.50 x 40.0
