CoyBeard/Mirobot-Frame-Building-Cell/CAD/Gantry System/Controllers/raspberry-pi-4-model-b-1.snapshot.3/Female USB Type C Connector, RPi4ModelB.SLDPRT

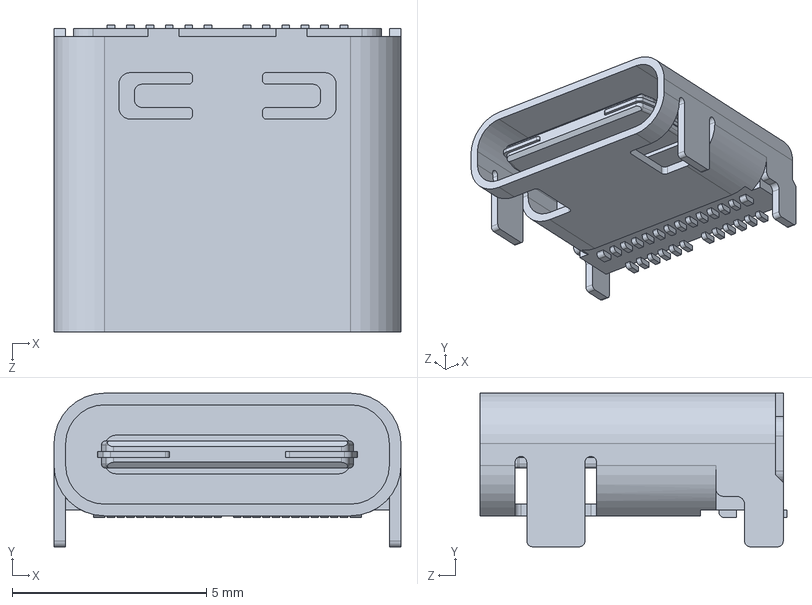
[picture p52: CAD file, 2023-06-10]
CAD/Gantry System/Controllers/raspberry-pi-4-model-b-1.snapshot.3/Female USB Type C Connector, RPi4ModelB.SLDPRT
8.94 x 3.96 x 7.90 mm
