CoyBeard/Mirobot-Frame-Building-Cell/CAD/Gantry System/3D Printed Parts/STLs/V1/Black PLA/6x  8mm ID 15mm Deep Idler Pully.stl

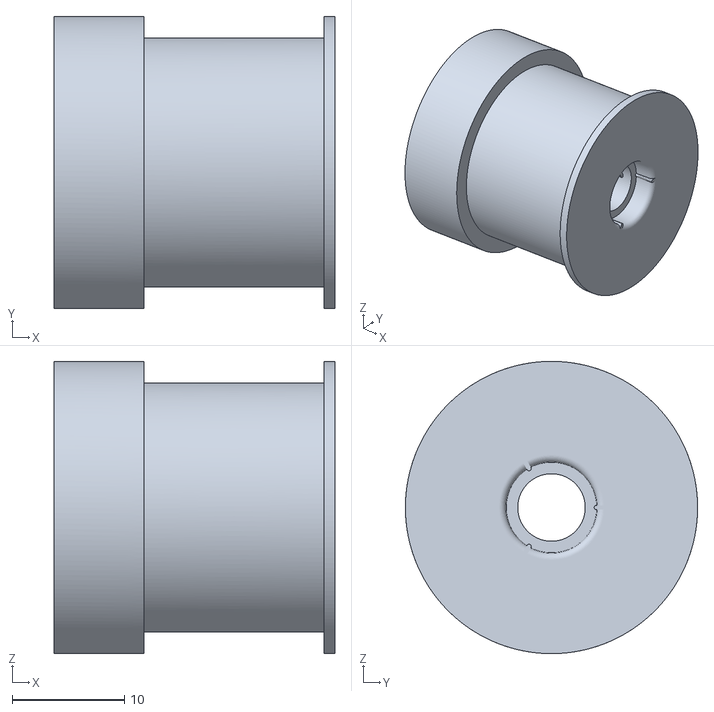
[picture p53: CAD file, 2023-06-10]
CAD/Gantry System/3D Printed Parts/STLs/V1/Black PLA/6x 8mm ID 15mm Deep Idler Pully.stl
25.0 x 26.0 x 26.0
