CoyBeard/Mirobot-Frame-Building-Cell/CAD/Gantry System/3D Printed Parts/STLs/V1/Black PLA/16x V Wheel Spacer.stl

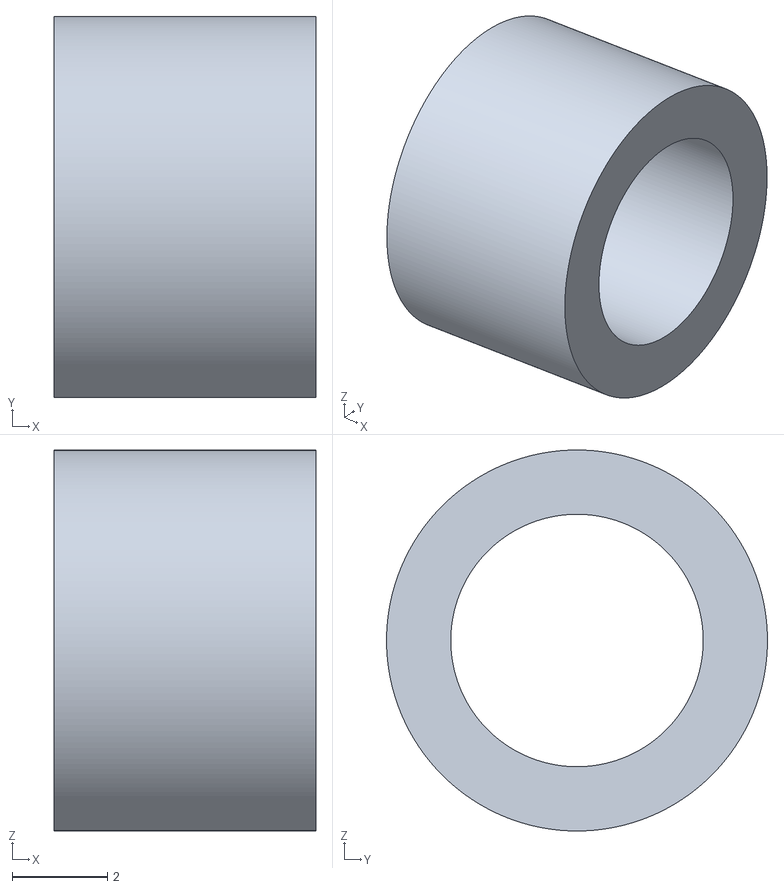
[picture p54: CAD file, 2023-06-10]
CAD/Gantry System/3D Printed Parts/STLs/V1/Black PLA/16x V Wheel Spacer.stl
5.50 x 8.00 x 8.00
