CoyBeard/Mirobot-Frame-Building-Cell/CAD/Gantry System/3D Printed Parts/STLs/V1/Black PLA/1x  X Axis Belt Tentoner NON ADJUSTABLE Base MIRRORED.stl

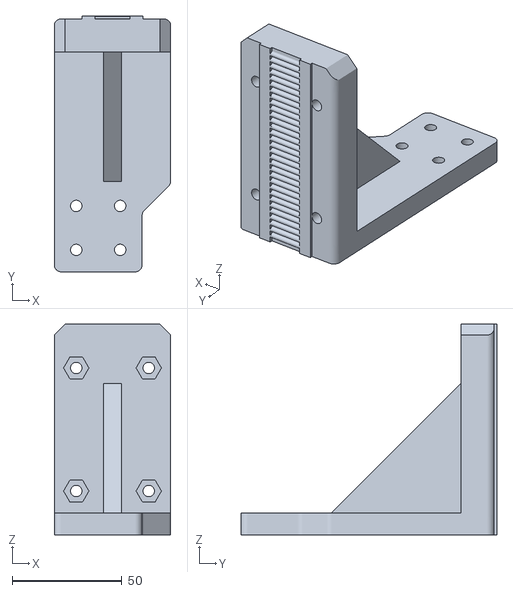
[picture p55: CAD file, 2023-06-10]
CAD/Gantry System/3D Printed Parts/STLs/V1/Black PLA/1x X Axis Belt Tentoner NON ADJUSTABLE Base MIRRORED.stl
53.0 x 116.3 x 96.0
