CoyBeard/Mirobot-Frame-Building-Cell/CAD/Gantry System/3D Printed Parts/STLs/V1/Black PLA/1x  X Axis Belt Tentoner NON ADJUSTABLE Base.stl

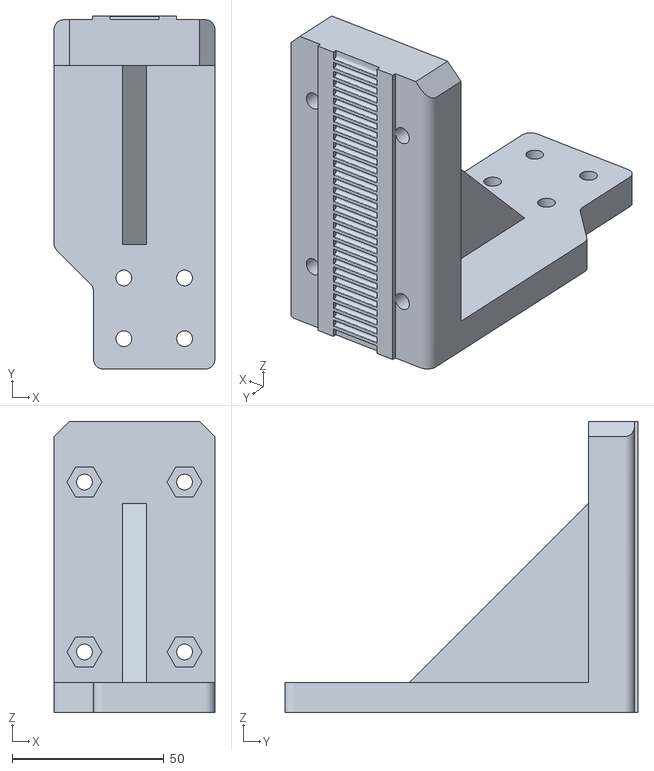
[picture p56: CAD file, 2023-06-10]
CAD/Gantry System/3D Printed Parts/STLs/V1/Black PLA/1x X Axis Belt Tentoner NON ADJUSTABLE Base.stl
53.0 x 116.3 x 96.0
