CoyBeard/Mirobot-Frame-Building-Cell/CAD/Gantry System/3D Printed Parts/STLs/V1/Black PLA/8x  Idler Pully Spacer.stl

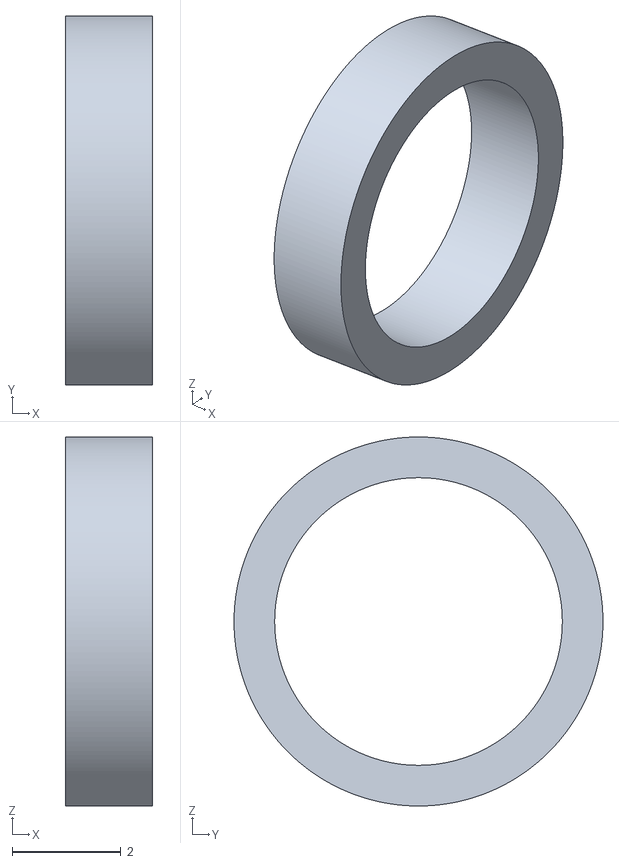
[picture p57: CAD file, 2023-06-10]
CAD/Gantry System/3D Printed Parts/STLs/V1/Black PLA/8x Idler Pully Spacer.stl
1.60 x 6.80 x 6.80
