CoyBeard/Mirobot-Frame-Building-Cell/CAD/Gantry System/3D Printed Parts/STLs/V1/Black PLA/1x  X Axis Belt Tentoner Base MIRRORED.stl

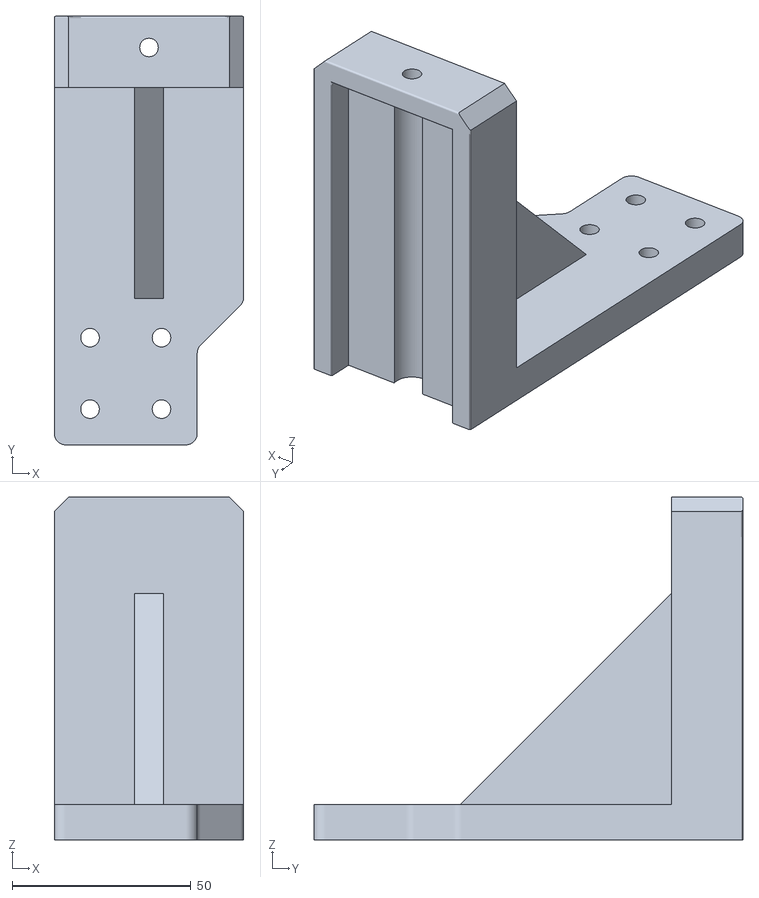
[picture p59: CAD file, 2023-06-10]
CAD/Gantry System/3D Printed Parts/STLs/V1/Black PLA/1x X Axis Belt Tentoner Base MIRRORED.stl
53.0 x 120.0 x 96.0
