CoyBeard/Mirobot-Frame-Building-Cell/CAD/Gantry System/3D Printed Parts/STLs/V1/Black PLA/2x  X Axis Belt Adjustable Grip Plate.stl

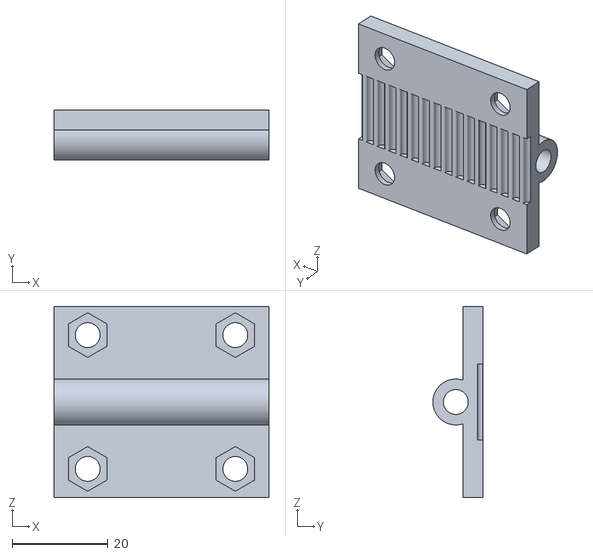
[picture p60: CAD file, 2023-06-10]
CAD/Gantry System/3D Printed Parts/STLs/V1/Black PLA/2x X Axis Belt Adjustable Grip Plate.stl
45.0 x 10.5 x 40.0
