CoyBeard/Mirobot-Frame-Building-Cell/CAD/Gantry System/3D Printed Parts/STLs/V1/Black PLA/1x  Y Axis Limit Switch Trigger.stl

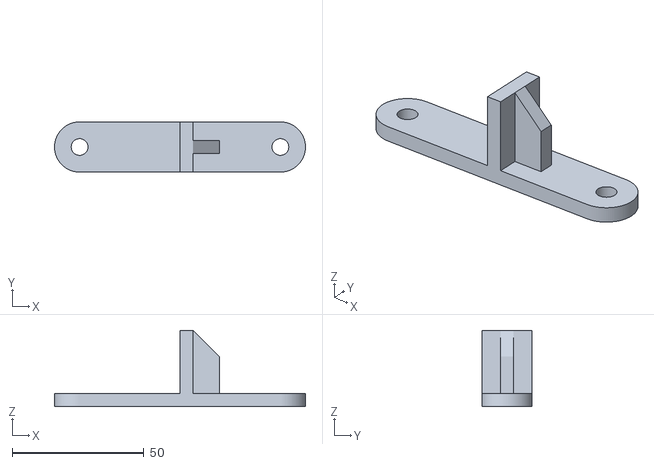
[picture p62: CAD file, 2023-06-10]
CAD/Gantry System/3D Printed Parts/STLs/V1/Black PLA/1x Y Axis Limit Switch Trigger.stl
95.2 x 19.0 x 29.0
