CoyBeard/Mirobot-Frame-Building-Cell/CAD/Gantry System/3D Printed Parts/STLs/V1/Black PLA/1x  Y Axis Belt Stationary Top.stl

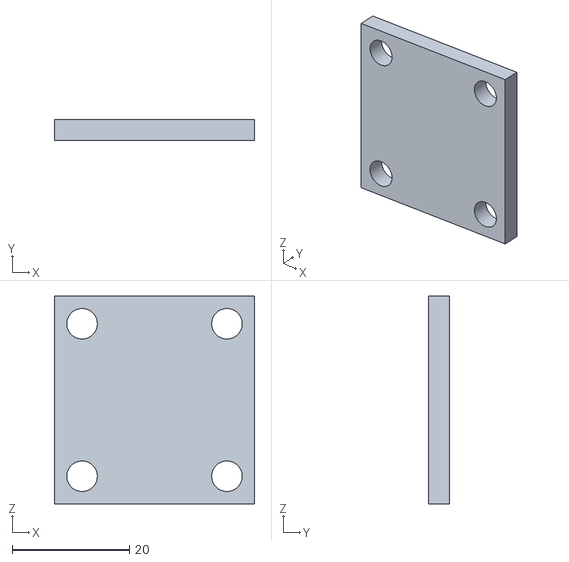
[picture p64: CAD file, 2023-06-10]
CAD/Gantry System/3D Printed Parts/STLs/V1/Black PLA/1x Y Axis Belt Stationary Top.stl
34.1 x 3.50 x 35.4
