CoyBeard/Mirobot-Frame-Building-Cell/CAD/Gantry System/3D Printed Parts/STLs/V1/Black PLA/1x  Y Axis Belt Stationary and Plate Spacer.stl

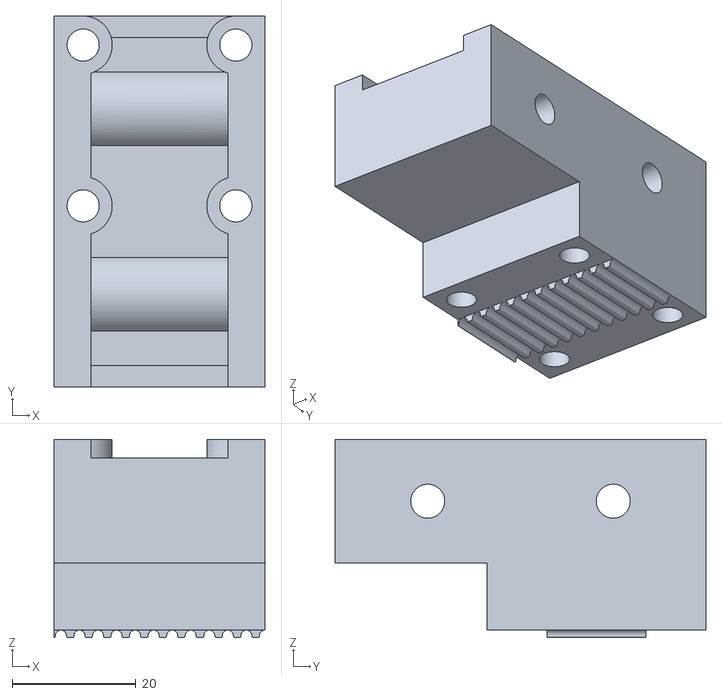
[picture p65: CAD file, 2023-06-10]
CAD/Gantry System/3D Printed Parts/STLs/V1/Black PLA/1x Y Axis Belt Stationary and Plate Spacer.stl
34.1 x 60.0 x 32.1
