CoyBeard/Mirobot-Frame-Building-Cell/CAD/Gantry System/3D Printed Parts/STLs/V1/Black PLA/1x  0.5in Flanged Pillowblock Frame.stl

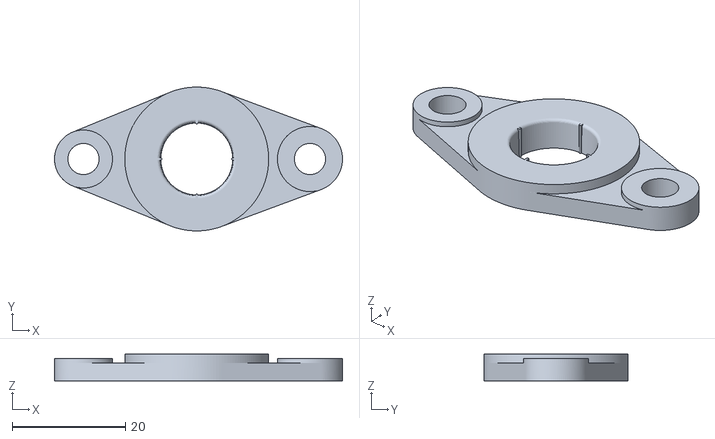
[picture p66: CAD file, 2023-06-10]
CAD/Gantry System/3D Printed Parts/STLs/V1/Black PLA/1x 0.5in Flanged Pillowblock Frame.stl
50.9 x 25.4 x 4.76
