CoyBeard/Mirobot-Frame-Building-Cell/CAD/Gantry System/3D Printed Parts/STLs/V1/Black PLA/2x  X Axis Belt Tentoner NON ADJUSTABLE Top.stl

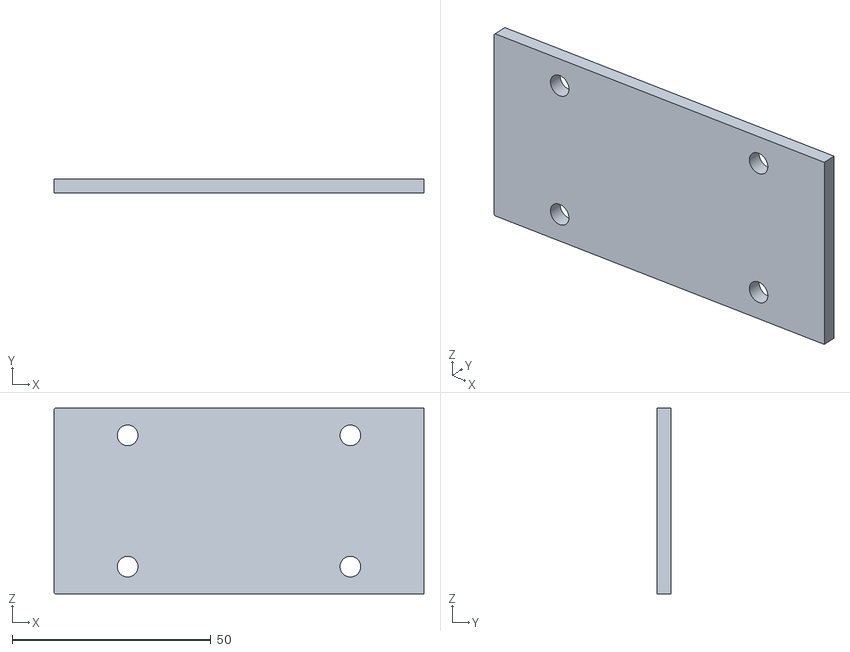
[picture p67: CAD file, 2023-06-10]
CAD/Gantry System/3D Printed Parts/STLs/V1/Black PLA/2x X Axis Belt Tentoner NON ADJUSTABLE Top.stl
93.0 x 3.50 x 46.7
