CoyBeard/Mirobot-Frame-Building-Cell/CAD/Gantry System/3D Printed Parts/STLs/V1/Black PLA/1x  X Axis Limit Switch Bracket.stl

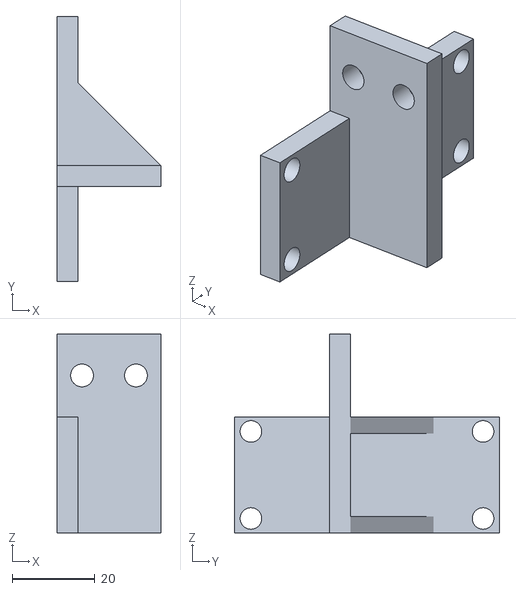
[picture p68: CAD file, 2023-06-10]
CAD/Gantry System/3D Printed Parts/STLs/V1/Black PLA/1x X Axis Limit Switch Bracket.stl
25.0 x 64.0 x 48.0
