CoyBeard/Mirobot-Frame-Building-Cell/CAD/Gantry System/3D Printed Parts/STLs/V1/Black PLA/3x  Z Axis Cover Frame.stl

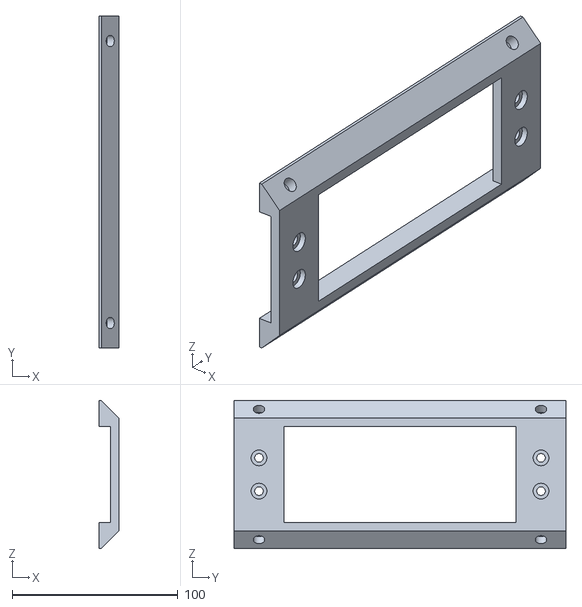
[picture p69: CAD file, 2023-06-10]
CAD/Gantry System/3D Printed Parts/STLs/V1/Black PLA/3x Z Axis Cover Frame.stl
12.1 x 200.0 x 89.2
