CoyBeard/Mirobot-Frame-Building-Cell/CAD/Gantry System/3D Printed Parts/STLs/V1/Black PLA/1x  Y Axis Limit Switch and Drag Chain Mount.stl

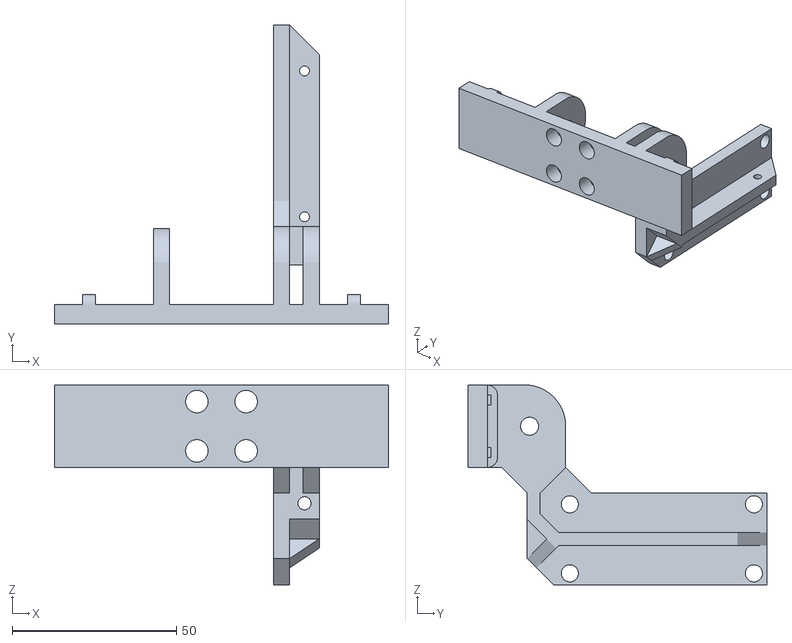
[picture p72: CAD file, 2023-06-10]
CAD/Gantry System/3D Printed Parts/STLs/V1/Black PLA/1x Y Axis Limit Switch and Drag Chain Mount.stl
101.6 x 91.0 x 60.8
