CoyBeard/Mirobot-Frame-Building-Cell/CAD/Gantry System/3D Printed Parts/STLs/V1/Black PLA/1x  Y Axis Drag Chain Mount Stationary.stl

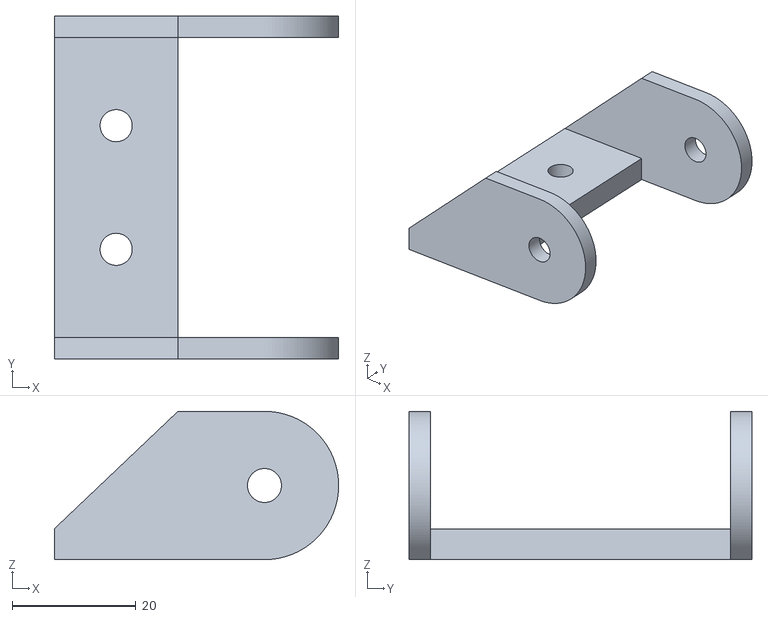
[picture p74: CAD file, 2023-06-10]
CAD/Gantry System/3D Printed Parts/STLs/V1/Black PLA/1x Y Axis Drag Chain Mount Stationary.stl
46.0 x 55.5 x 24.0
