CoyBeard/Mirobot-Frame-Building-Cell/(list of files, cad)

Other CAD files:
CAD/Gantry System/Electrical/GAM2000 Wiring Diagram.igs
CAD/Gantry System/Machined Parts/Generic 3x3 Corner Connecting Gusset.dwg
CAD/Gantry System/3D Printed Parts/Raspberry Pi 4B Case/Pi4caseTop180.stl
CAD/Gantry System/Machined Parts/4in x 6in Steel Rectangular Tubing 4in long Machined.dwg
CAD/Gantry System/3D Printed Parts/Raspberry Pi 4B Case/Pi4caseBottom.stl
CAD/Gantry System/3D Printed Parts/STLs/V1/Black PLA/1x X Axis Belt Tentoner Base.stl
CAD/Gantry System/110AC Fan.ipt
CAD/Gantry System/14x20 ATNT Sign.ipt
CAD/Gantry System/2020 Extrusion 90deg 2Hole Aluminum Bracket.ipt
CAD/Gantry System/2020 Extrusion 90deg 4Hole Aluminum Bracket.ipt
CAD/Gantry System/25Pin D SUB Female Connector.ipt
CAD/Gantry System/25Pin D SUB Male Connector.ipt
CAD/Gantry System/3D Printed Parts/Axis 4 Bearing 25mm Spacer.ipt
CAD/Gantry System/3D Printed Parts/Axis 4 Female Bearing Connector Bracket.ipt
CAD/Gantry System/3D Printed Parts/Axis 4 Male Bearing Connector Bracket.ipt
CAD/Gantry System/3D Printed Parts/BTT Octopus 1.1 Mount.ipt
CAD/Gantry System/3D Printed Parts/DCDC Converter Mount.ipt
CAD/Gantry System/3D Printed Parts/Drok L298 DC Motor Driver Mount.ipt
CAD/Gantry System/3D Printed Parts/Elegoo 8 Channel Relay Module Mount.ipt
CAD/Gantry System/3D Printed Parts/Idler Pully Spacer X Axis 3mm.ipt
CAD/Gantry System/3D Printed Parts/Idler Pully Spacer X Axis 7mm.ipt
CAD/Gantry System/3D Printed Parts/Idler Pully Spacer.ipt
CAD/Gantry System/3D Printed Parts/JR Logo Text.ipt
CAD/Gantry System/3D Printed Parts/Operator Junction Box Main.ipt
CAD/Gantry System/3D Printed Parts/Operator Junction Box Side Panel.ipt
CAD/Gantry System/3D Printed Parts/Pi GPIO Mount.ipt
CAD/Gantry System/3D Printed Parts/STLs/V1/Black PLA/1x X Axis Drag Chain Mount Statonary Bolted.stl
CAD/Gantry System/3D Printed Parts/STLs/V1/Black PLA/1x Y Axis Drag Chain Mount Bolted.stl
CAD/Gantry System/3D Printed Parts/Signal Tower Mount.ipt
CAD/Gantry System/3D Printed Parts/V Wheel Spacer.ipt
CAD/Gantry System/3D Printed Parts/Wire Anchor.ipt
CAD/Gantry System/3D Printed Parts/X Axis Belt Adjustable Grip Plate.ipt
CAD/Gantry System/3D Printed Parts/X Axis Belt Adjustable Top.ipt
CAD/Gantry System/3D Printed Parts/X Axis Belt Tentoner Base MIRRORED.ipt
CAD/Gantry System/3D Printed Parts/X Axis Belt Tentoner Base.ipt
CAD/Gantry System/3D Printed Parts/X Axis Belt Tentoner NON ADJUSTABLE Base MIRRORED.ipt
CAD/Gantry System/3D Printed Parts/X Axis Belt Tentoner NON ADJUSTABLE Base.ipt
CAD/Gantry System/3D Printed Parts/X Axis Belt Tentoner NON ADJUSTABLE Top.ipt
CAD/Gantry System/3D Printed Parts/X Axis Belt and V Wheel Plate Spacer.ipt
CAD/Gantry System/3D Printed Parts/X Axis Drag Chain Mount Moble.ipt
CAD/Gantry System/3D Printed Parts/X Axis Drag Chain Mount Statonary Bolted.ipt
CAD/Gantry System/3D Printed Parts/X Axis Drag Chain Support Mount.ipt
CAD/Gantry System/3D Printed Parts/X Axis Limit Switch Bracket.ipt
CAD/Gantry System/3D Printed Parts/X Axis Pully Support.ipt
CAD/Gantry System/3D Printed Parts/Y Axis Belt Adjustable Grip Plate.ipt
CAD/Gantry System/3D Printed Parts/Y Axis Belt Adjustable Top.ipt
CAD/Gantry System/3D Printed Parts/Y Axis Belt Adjustable and Plate Spacer.ipt
CAD/Gantry System/3D Printed Parts/Y Axis Belt Stationary Top.ipt
CAD/Gantry System/3D Printed Parts/Y Axis Belt Stationary and Plate Spacer.ipt
CAD/Gantry System/3D Printed Parts/Y Axis Drag Chain Mount Bolted.ipt
CAD/Gantry System/3D Printed Parts/Y Axis Drag Chain Mount Stationary.ipt
CAD/Gantry System/3D Printed Parts/Y Axis Limit Switch Mount.ipt
CAD/Gantry System/3D Printed Parts/Y Axis Limit Switch Trigger.ipt
CAD/Gantry System/3D Printed Parts/Y Axis Limit Switch and Drag Chain Mount.ipt
CAD/Gantry System/3D Printed Parts/Z Axis Cover Bottom.ipt
CAD/Gantry System/3D Printed Parts/Z Axis Cover Frame Bottom.ipt
CAD/Gantry System/3D Printed Parts/Z Axis Cover Frame.ipt
CAD/Gantry System/3D Printed Parts/Z Axis Cover Top Logo.ipt
CAD/Gantry System/3D Printed Parts/Z Axis Cover.ipt
CAD/Gantry System/3D Printed Parts/Z Axis Housing Frame Top Frunt.ipt
CAD/Gantry System/3D Printed Parts/Z Axis Limt Adjustable Trigger.ipt
CAD/Gantry System/3in x 5in Steel Rectangular Tubing 4in long.ipt
CAD/Gantry System/90 deg Shelf 4 Hole Bracket.ipt
CAD/Gantry System/Aluminum Extrusion/2020/2020 profile.ipt
CAD/Gantry System/Aluminum Extrusion/2020/2020-2 profile.ipt
CAD/Gantry System/Aluminum Extrusion/2020/20mm X 20mm X 10in aluminium profile v slot.ipt
CAD/Gantry System/Aluminum Extrusion/2020/20mm X 20mm X 12in aluminium profile v slot.ipt
CAD/Gantry System/Aluminum Extrusion/2020/20mm X 20mm X 15.3in aluminium profile v slot.ipt
CAD/Gantry System/Aluminum Extrusion/2020/20mm X 20mm X 15.75in 68degree aluminium profile v slot.ipt
CAD/Gantry System/Aluminum Extrusion/2020/20mm X 20mm X 150mm aluminium profile v slot.ipt
CAD/Gantry System/Aluminum Extrusion/2020/20mm X 20mm X 15in aluminium profile v slot.ipt
CAD/Gantry System/Aluminum Extrusion/2020/20mm X 20mm X 17in aluminium profile v slot.ipt
CAD/Gantry System/Aluminum Extrusion/2020/20mm X 20mm X 180mm aluminium profile v slot.ipt
CAD/Gantry System/Aluminum Extrusion/2020/20mm X 20mm X 19n 68degree aluminium profile v slot.ipt
CAD/Gantry System/Aluminum Extrusion/2020/20mm X 20mm X 2.25in aluminium profile v slot.ipt
CAD/Gantry System/Aluminum Extrusion/2020/20mm X 20mm X 200mm aluminium profile v slot.ipt
CAD/Gantry System/Aluminum Extrusion/2020/20mm X 20mm X 32in aluminium profile v slot.ipt
CAD/Gantry System/Aluminum Extrusion/2020/20mm X 20mm X 35in aluminium profile v slot.ipt
CAD/Gantry System/Aluminum Extrusion/2020/20mm X 20mm X 4ft aluminium profile v slot.ipt
CAD/Gantry System/Aluminum Extrusion/2020/20mm X 20mm X 6.25in aluminium profile v slot.ipt
CAD/Gantry System/Aluminum Extrusion/2020/20mm X 20mm X 601.6mm aluminium profile v slot.ipt
CAD/Gantry System/Aluminum Extrusion/2020/20mm X 20mm X 6in aluminium profile v slot.ipt
CAD/Gantry System/Aluminum Extrusion/2020/20mm X 20mm X 6in+20mm aluminium profile v slot.ipt
CAD/Gantry System/Aluminum Extrusion/2020/20mm X 20mm X 720mm Silver aluminium profile v slot.ipt
CAD/Gantry System/Aluminum Extrusion/2020/20mm X 20mm X 760mm Silver aluminium profile v slot.ipt
CAD/Gantry System/Aluminum Extrusion/2020/20mm X 20mm X 8.213in aluminium profile v slot.ipt
CAD/Gantry System/Aluminum Extrusion/2020/20mm X 20mm X 8in aluminium profile v slot.ipt
CAD/Gantry System/Aluminum Extrusion/2020/OldVersions/20mm X 20mm X 150mm aluminium profile v slot.0003.ipt
CAD/Gantry System/Aluminum Extrusion/2020/OldVersions/20mm X 20mm X 200mm aluminium profile v slot.0003.ipt
CAD/Gantry System/Aluminum Extrusion/2020/OldVersions/20mm X 20mm X 32in aluminium profile v slot.0001.ipt
CAD/Gantry System/Aluminum Extrusion/2020/OldVersions/20mm X 20mm X 35in aluminium profile v slot.0006.ipt
CAD/Gantry System/Aluminum Extrusion/2020/OldVersions/20mm X 20mm X 4ft aluminium profile v slot.0004.ipt
CAD/Gantry System/Aluminum Extrusion/2020/OldVersions/20mm X 20mm X 601.6mm aluminium profile v slot.0004.ipt
CAD/Gantry System/Aluminum Extrusion/2020/OldVersions/20mm X 20mm X 720mm Silver aluminium profile v slot.0006.ipt
CAD/Gantry System/Aluminum Extrusion/2020/OldVersions/20mm X 20mm X 760mm Silver aluminium profile v slot.0005.ipt
CAD/Gantry System/Aluminum Extrusion/2020/OldVersions/20mm X 20mm X 8in aluminium profile v slot.0002.ipt
CAD/Gantry System/Aluminum Extrusion/2040/2040-2 profile (2021_08_15 23_37_01 UTC).ipt
CAD/Gantry System/Aluminum Extrusion/2040/2040-3L profile (2021_08_15 23_37_01 UTC).ipt
CAD/Gantry System/Aluminum Extrusion/2040/2040-3R profile (2021_08_15 23_37_01 UTC).ipt
CAD/Gantry System/Aluminum Extrusion/2040/2040x1000 With 40mm Notch silver profile.ipt
CAD/Gantry System/Aluminum Extrusion/2040/2040x1000 silver profile.ipt
CAD/Gantry System/Aluminum Extrusion/2040/2040x190 silver profile.ipt
CAD/Gantry System/Aluminum Extrusion/2040/2040x1991 silver profile.ipt
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
