CoyBeard/Mirobot-Frame-Building-Cell/CAD/Gantry System/Photos/Signal Tower Wiring Diagram.jpg

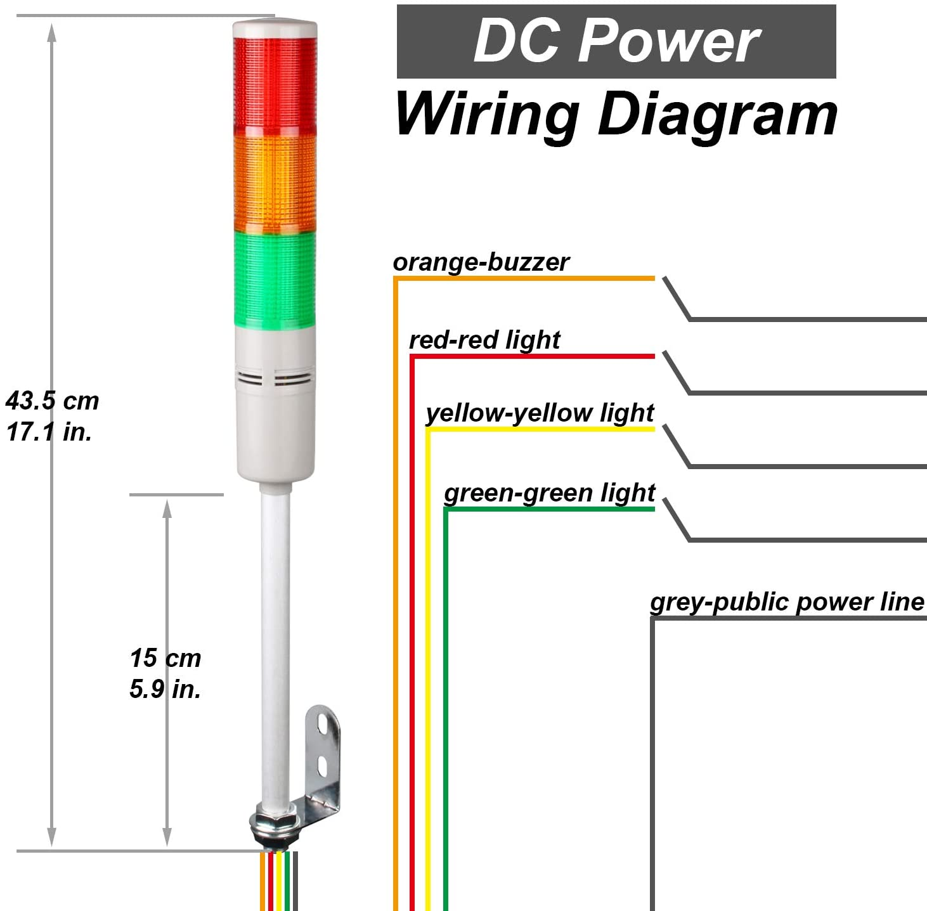
CAD/Gantry System/Photos/Signal Tower Wiring Diagram.jpg
