CoyBeard/Mirobot-Frame-Building-Cell/Code/VSCode/Mirobot Frame Building Cell Program GUI TK Source Code V1.1/Images/Frame Building Canvas Max Position.png

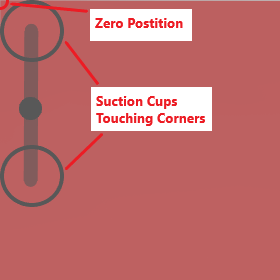
Code/VSCode/Mirobot Frame Building Cell Program GUI TK Source Code V1.1/Images/Frame Building Canvas Max Position.png
