CoyBeard/Mirobot-Frame-Building-Cell/CAD/Gantry System/Machined Parts/2040x1000 With 40mm Notch silver profile.pdf

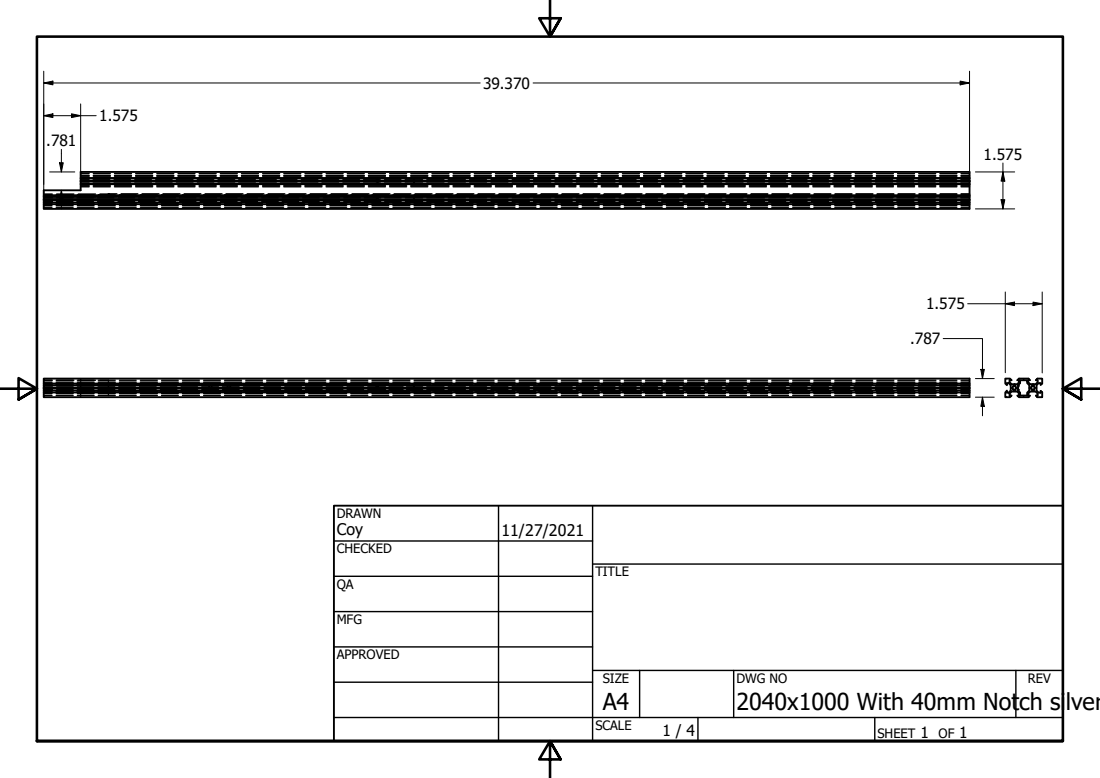
[picture p80: page 1]

DRAWN Coy | 11/27/2021

CHECKED

MFG

APPROVED

SIZE A4 | DWG NO | REV

2040x1000 With 40mm Notch silver

SCALE 1 / 4 | | SHEET 1 OF 1
