CoyBeard/Mirobot-Frame-Building-Cell/CAD/Gantry System/Machined Parts/4in x 6in Steel Rectangular Tubing 4in long Machined.pdf

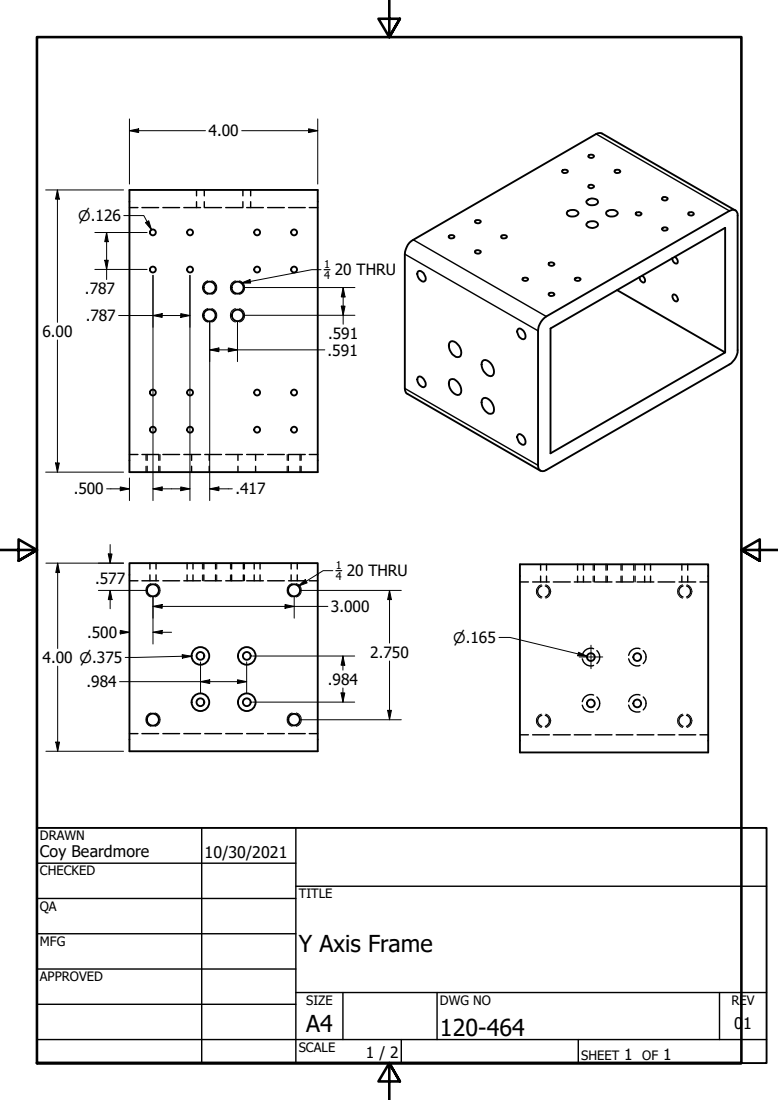
[picture p81: page 1]
4 20 THRU

DRAWN Coy Beardmore | 10/30/2021

CHECKED

TITLE Y Axis Frame

MFG

APPROVED

SIZE A4 | DWG NO 120-464 | REV 01

SCALE 1 / 2 | | SHEET 1 OF 1
