CoyBeard/Mirobot-Frame-Building-Cell/CAD/Gantry System/Electrical/GAM2000 Wiring Diagram P1.pdf

100

102

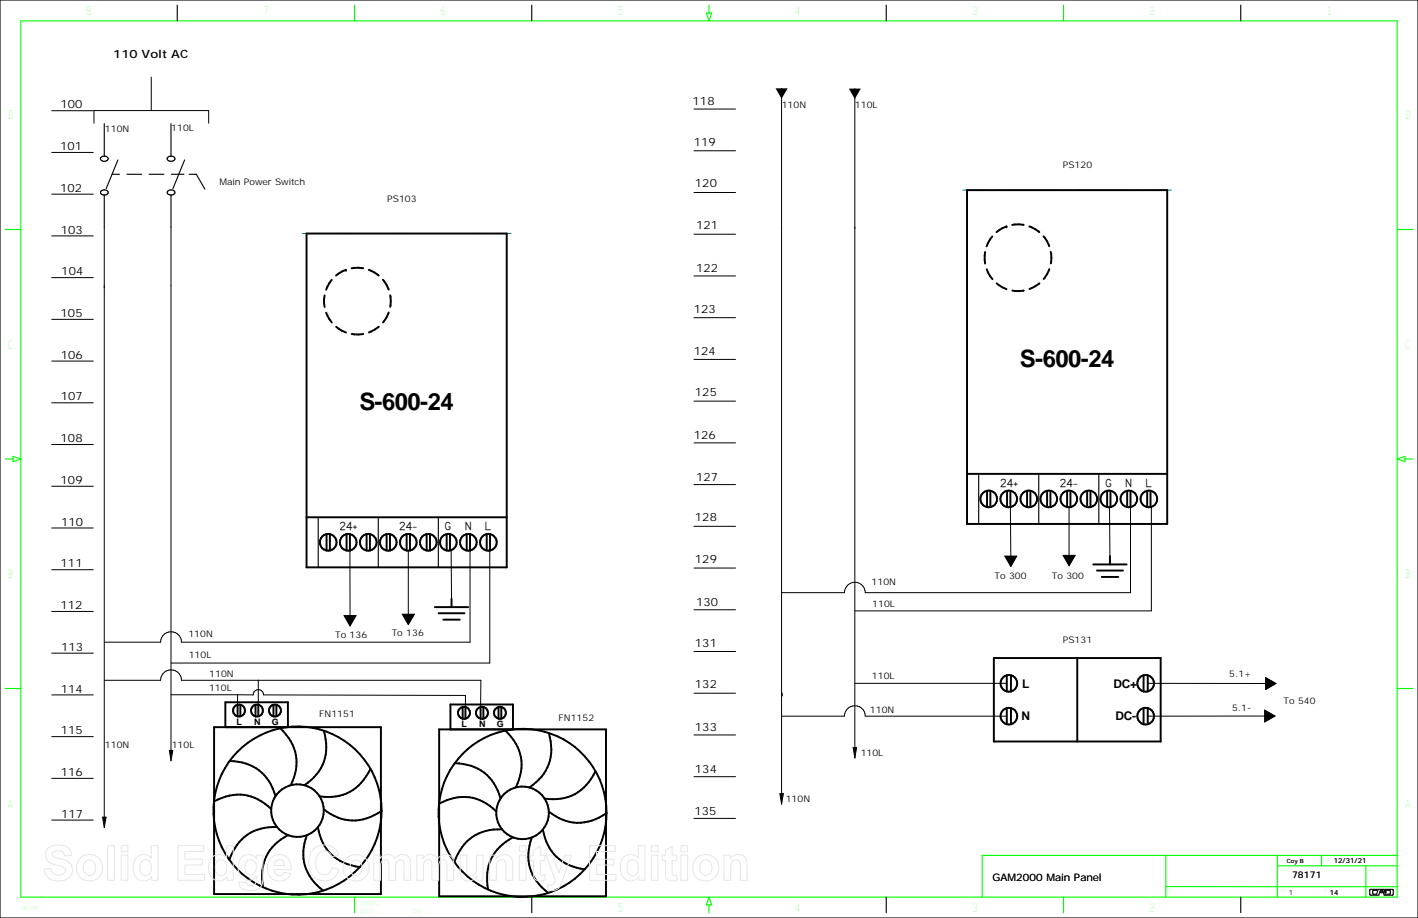
[picture p82: page 1]
CAD PART; SELECT:; ECHO:; LAYERING; 110 Volt AC

Main Power Switch

GAM2000 Main Panel | | DWN Coy B Coy B | 12/31/21 12/31/21 DATE

Job NO 78171 78171 | DWG REV

CUST | 1 14 14 SHEET OF
