CoyBeard/Mirobot-Frame-Building-Cell/CAD/Gantry System/Electrical/GAM2000 Wiring Diagram P2.pdf

### 24 VDC

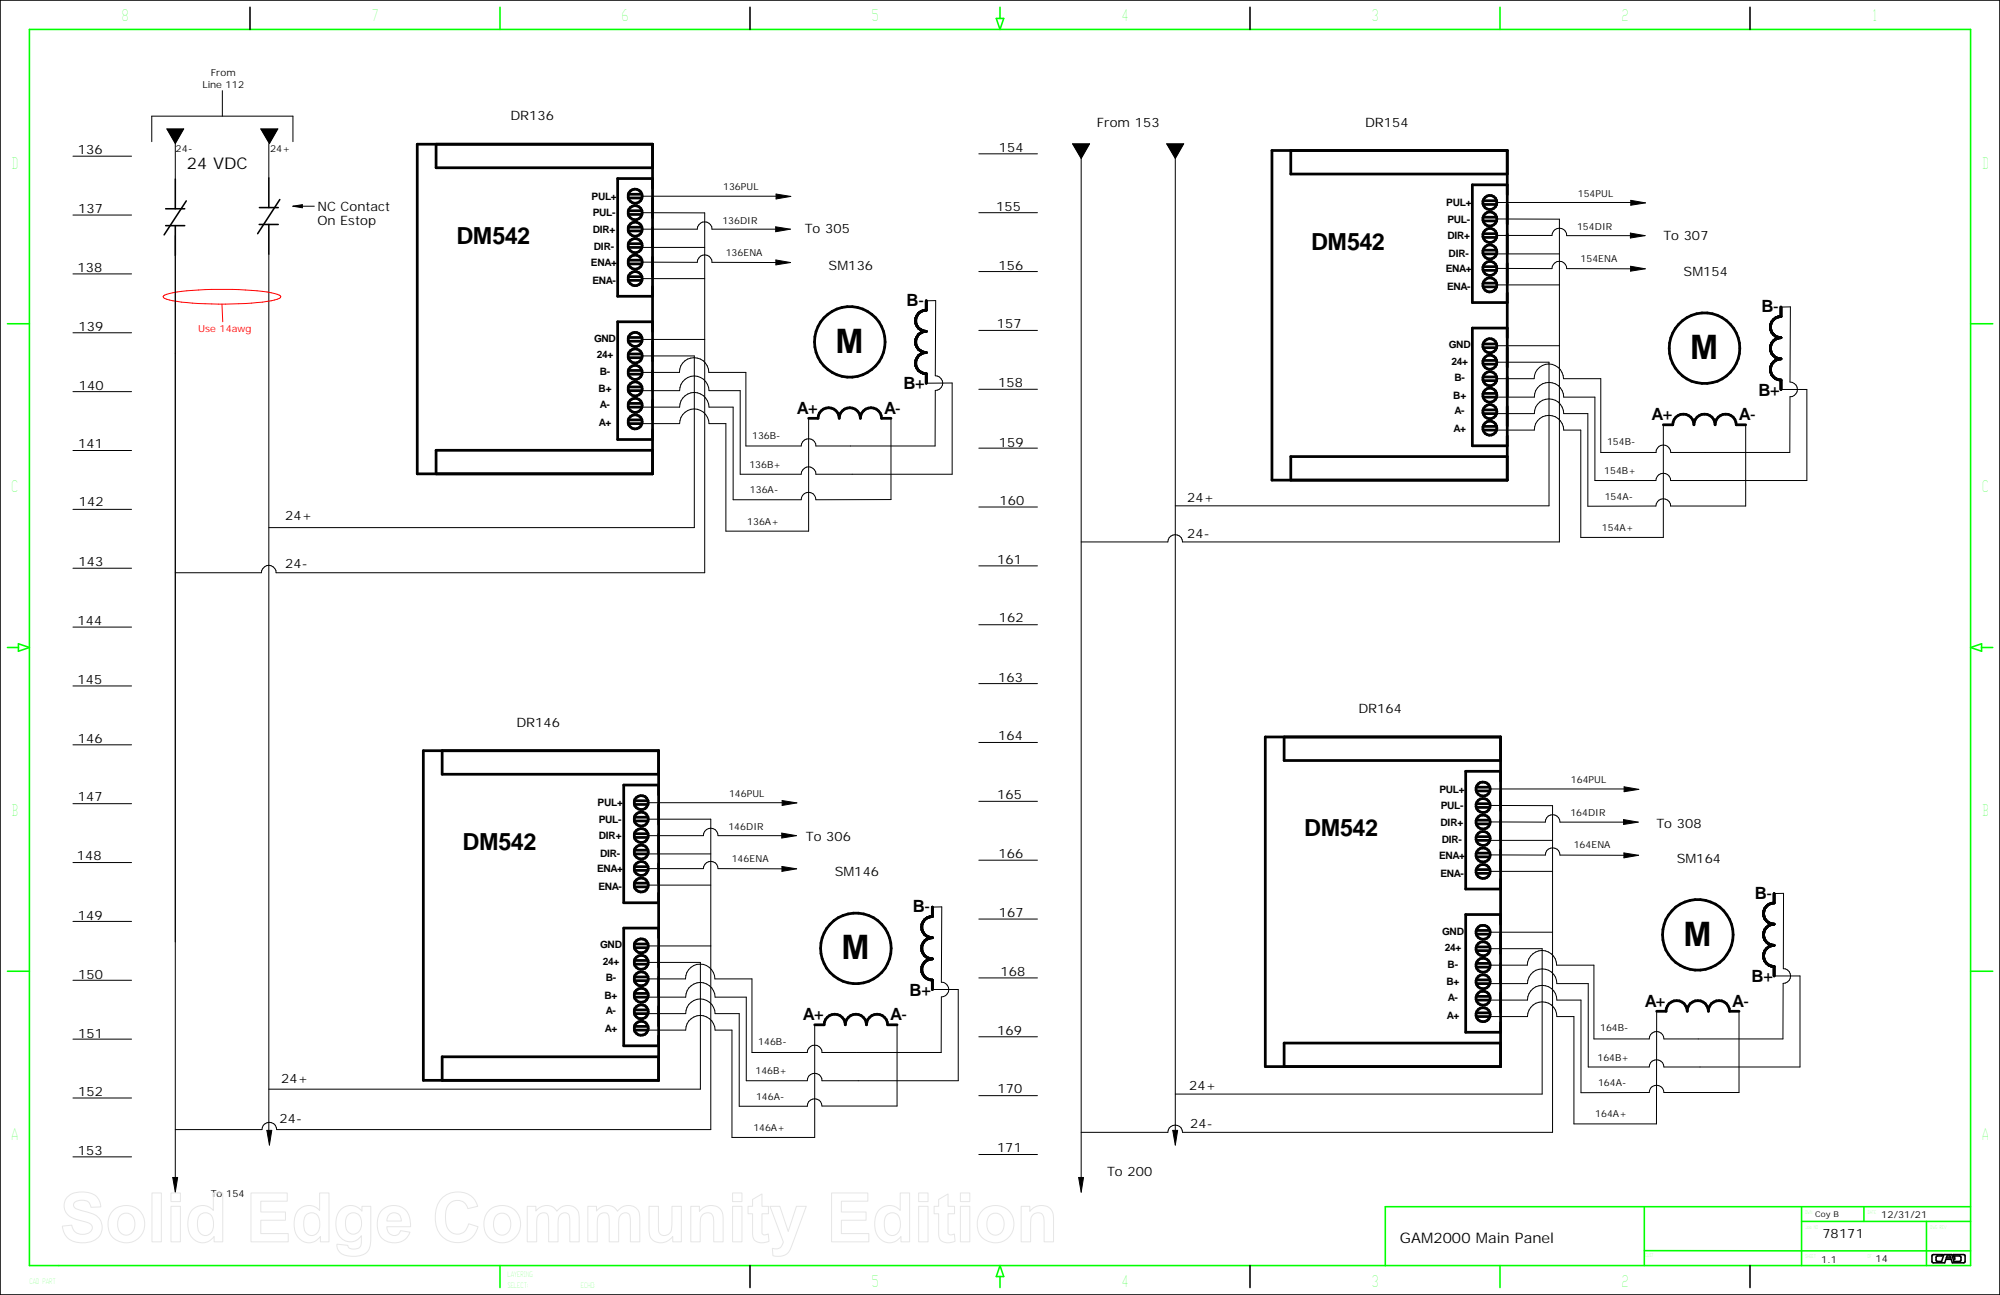
[picture p83: page 1]
CAD PART; SELECT:; ECHO:; LAYERING; Use 14awg; From Line 112; From 153; NC Contact On Estop; ENA-; DIR-; GND; 136PUL; 136DIR; 136ENA; 146PUL; 146DIR; 146ENA; 154PUL; 154DIR; 154ENA; 164PUL; 164DIR; 164ENA

PUL+ PUL- DIR+ ENA+ DM542

GAM2000 Main Panel | | DWN Coy B | 12/31/21 DATE

Job NO 78171 | DWG REV

CUST | 1.1 14 SHEET OF
