CoyBeard/Mirobot-Frame-Building-Cell/CAD/Gantry System/Electrical/GAM2000 Wiring Diagram P3.pdf

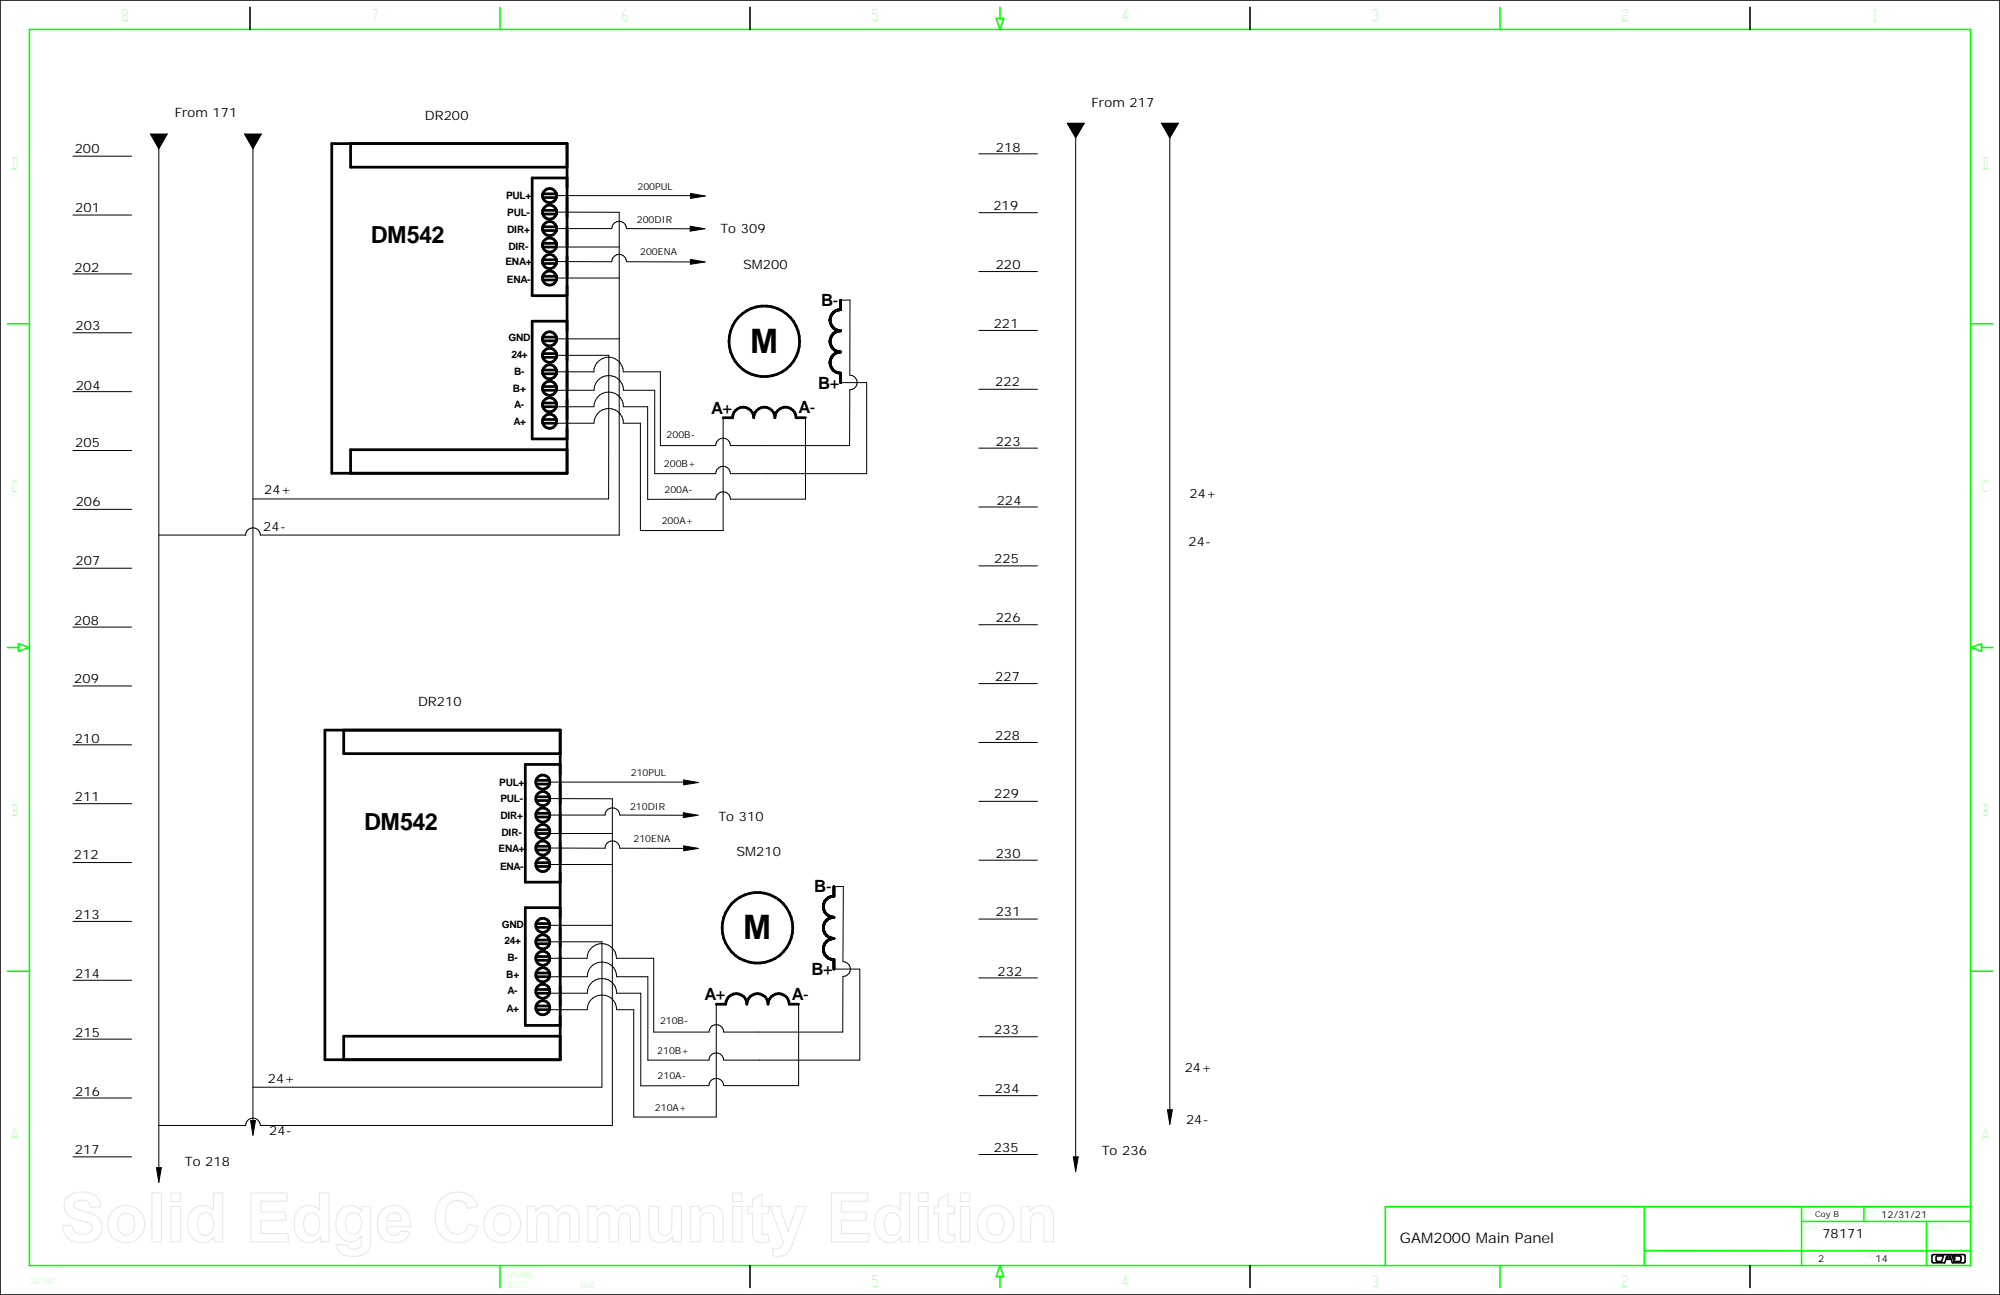
[picture p84: page 1]
CAD PART; SELECT:; ECHO:; LAYERING; From 217; From 171; ENA-; DIR-; GND; 200PUL; 200DIR; 200ENA; 210PUL; 210DIR; 210ENA

PUL+ PUL- DIR+ ENA+ DM542

GAM2000 Main Panel | | DWN Coy B | 12/31/21 DATE

Job NO 78171 | DWG REV

CUST | 2 14 SHEET OF
