CoyBeard/Mirobot-Frame-Building-Cell/CAD/Gantry System/Electrical/GAM2000 Wiring Diagram P4.pdf

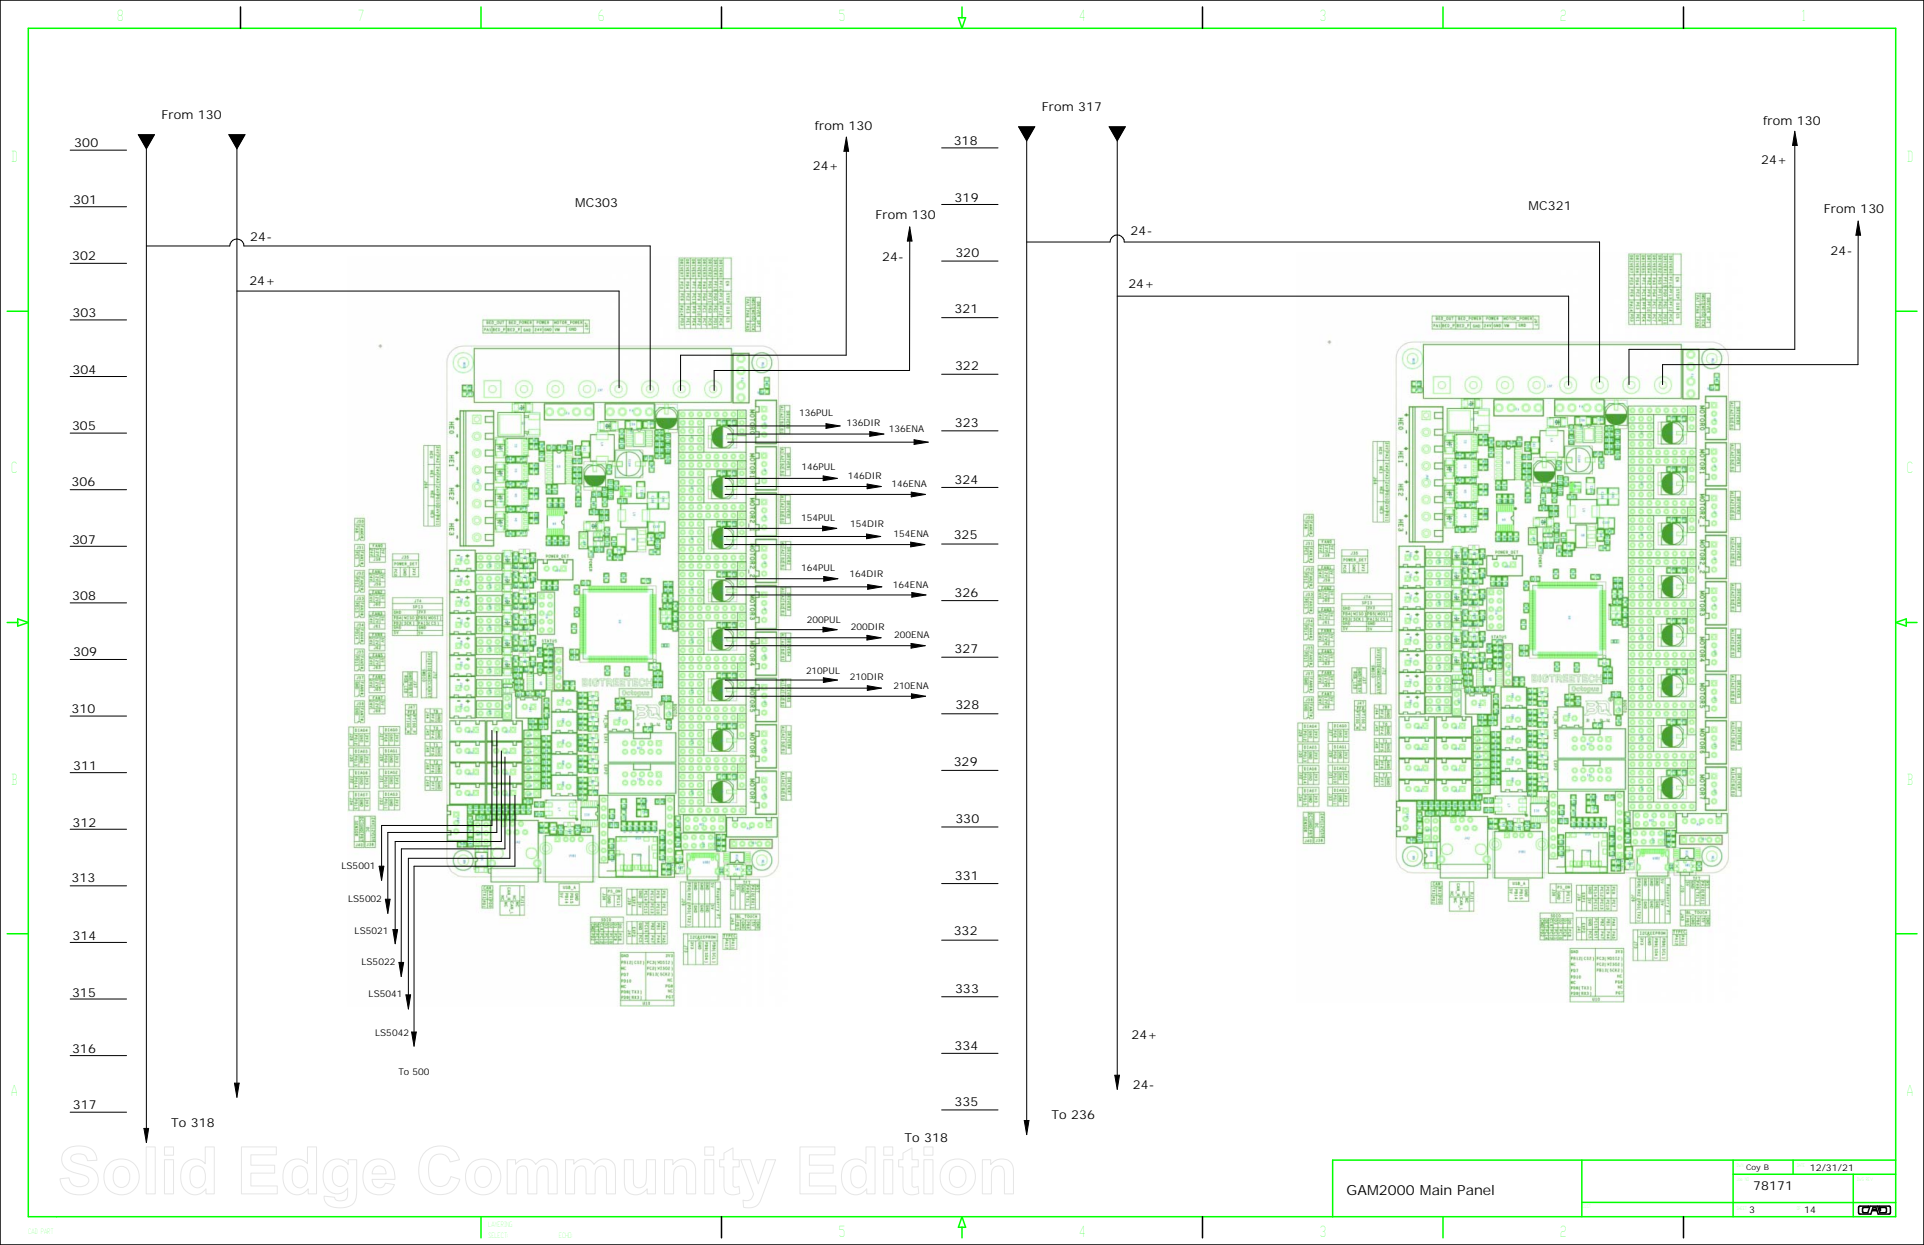
[picture p85: page 1]
CAD PART; SELECT:; ECHO:; LAYERING; From 130; from 130; From 317; 136PUL; 136DIR 136ENA; 146PUL; 154PUL; 164PUL; 200PUL; 210PUL; 146DIR; 154DIR; 164DIR; 200DIR; 210DIR; 146ENA; 154ENA; 164ENA; 200ENA; 210ENA

GAM2000 Main Panel | | DWN Coy B | 12/31/21 DATE

Job NO 78171 | DWG REV

CUST | 3 14 SHEET OF
