CoyBeard/Mirobot-Frame-Building-Cell/CAD/Gantry System/Electrical/GAM2000 Wiring Diagram P5.pdf

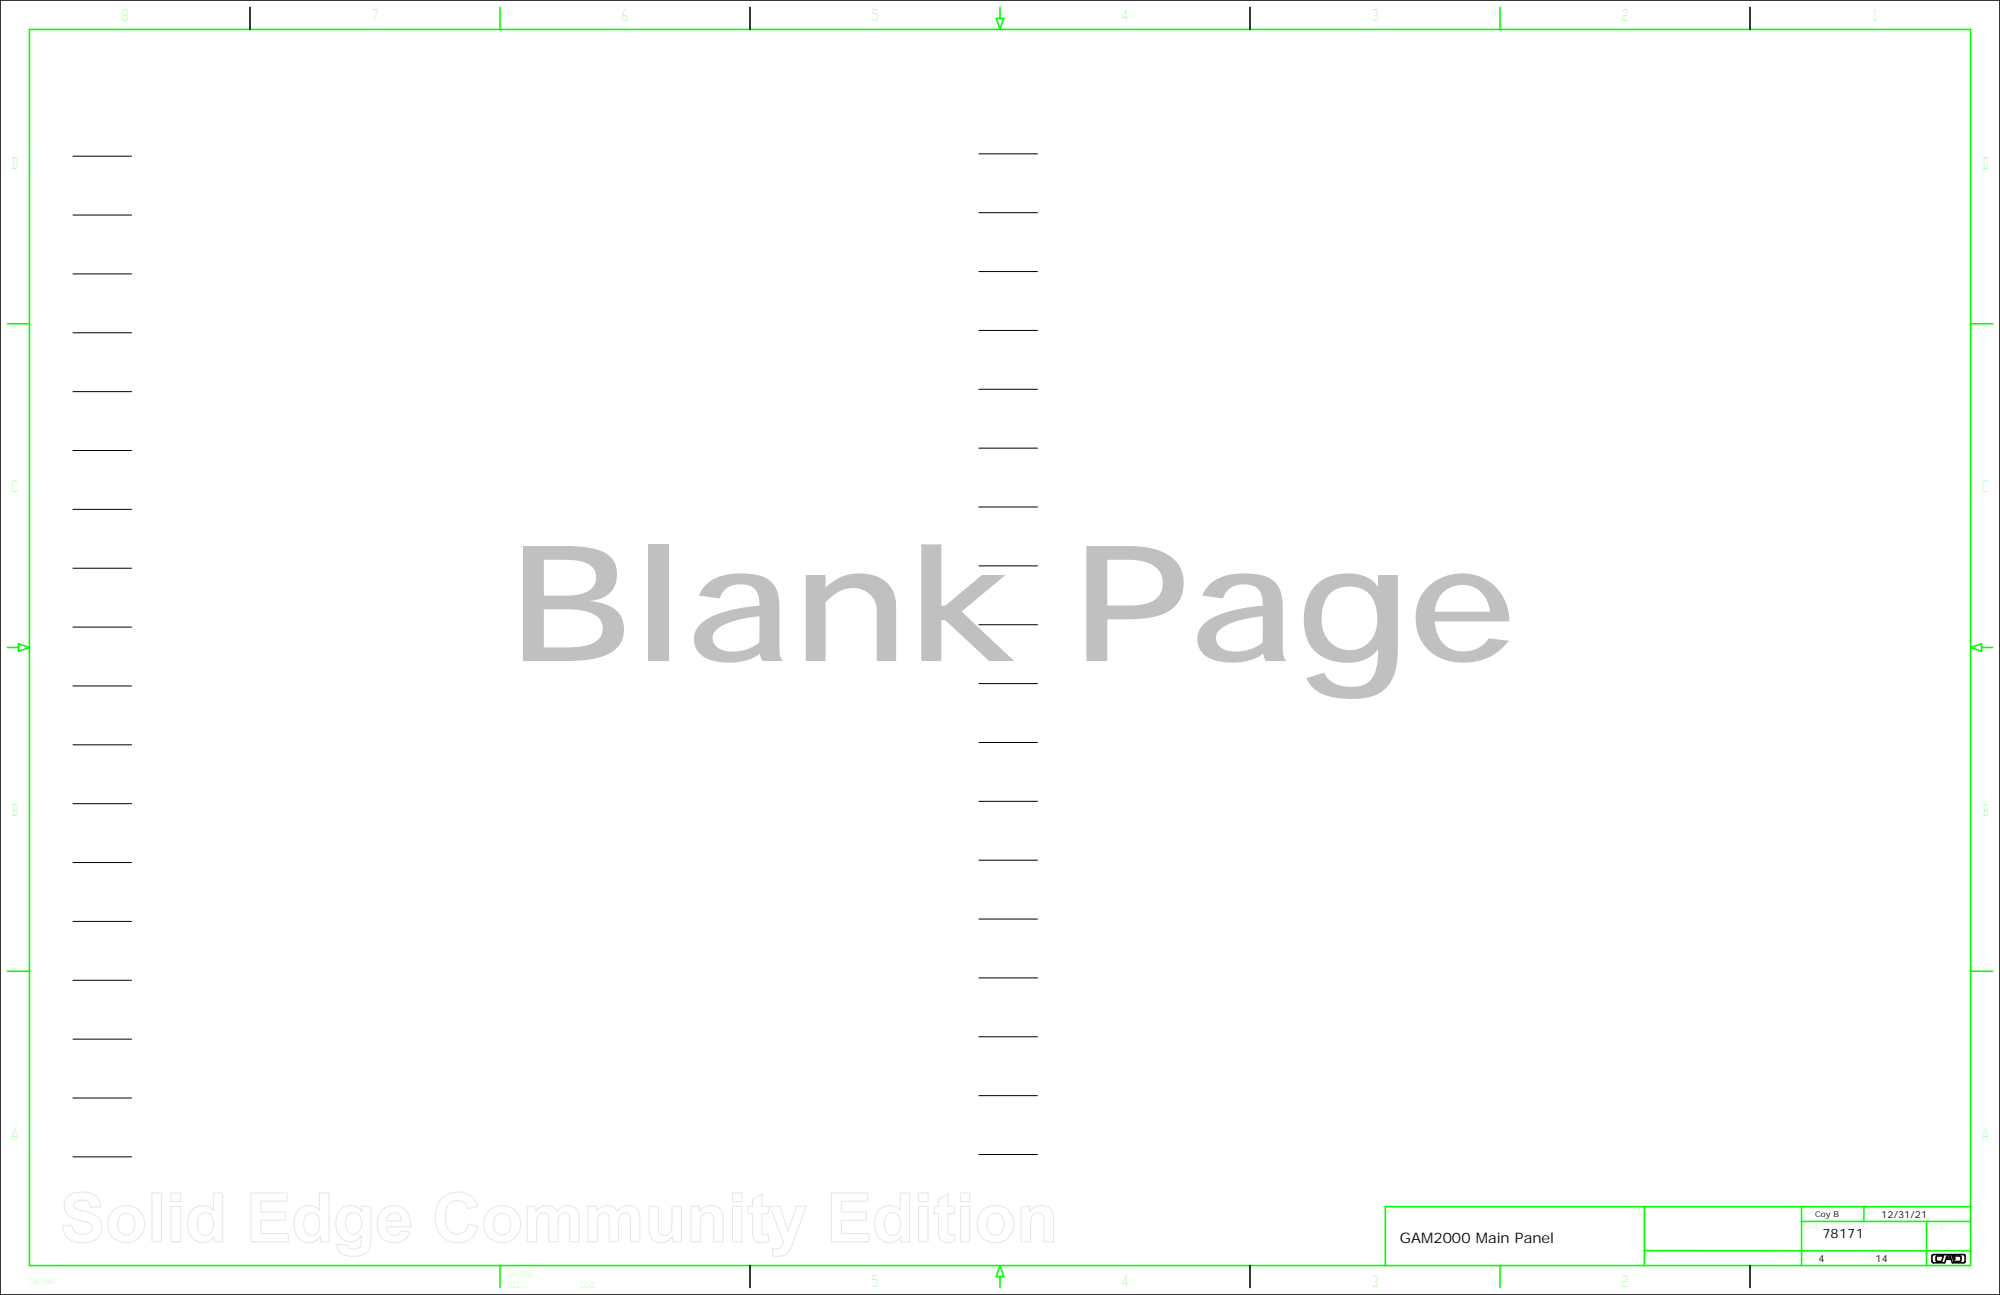
[picture p86: page 1]
CAD PART; SELECT:; ECHO:; LAYERING; Blank Page

GAM2000 Main Panel | | DWN Coy B | 12/31/21 DATE

Job NO 78171 | DWG REV

CUST | 4 14 SHEET OF
