CoyBeard/Mirobot-Frame-Building-Cell/CAD/Gantry System/Electrical/GAM2000 Wiring Diagram P6.pdf

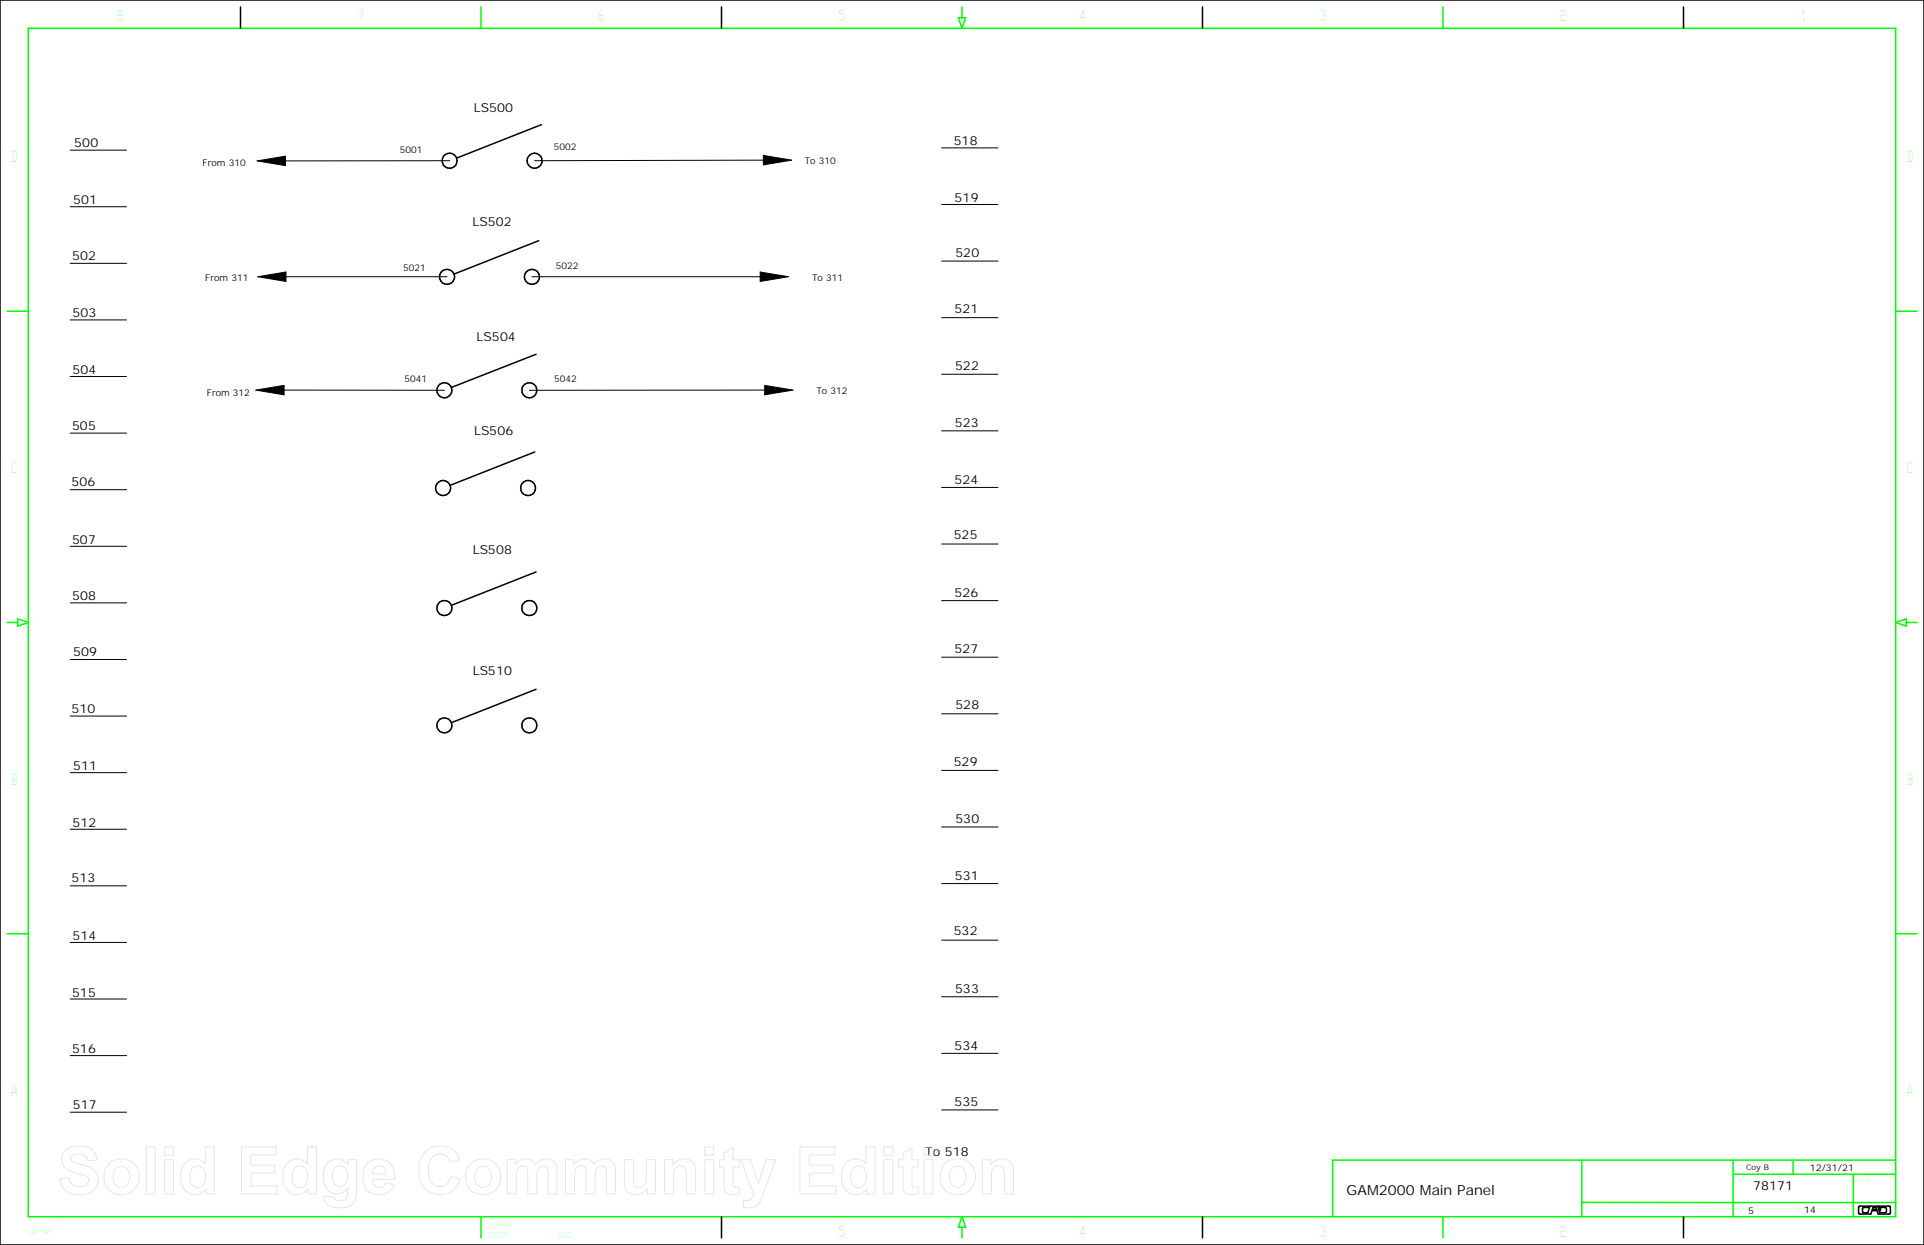
[picture p87: page 1]
CAD PART; SELECT:; ECHO:; LAYERING; From 310; From 311; From 312

GAM2000 Main Panel | | DWN Coy B | 12/31/21 DATE

Job NO 78171 | DWG REV

CUST | 5 14 SHEET OF
