CoyBeard/Mirobot-Frame-Building-Cell/CAD/Gantry System/Electrical/GAM2000 Wiring Diagram P7.pdf

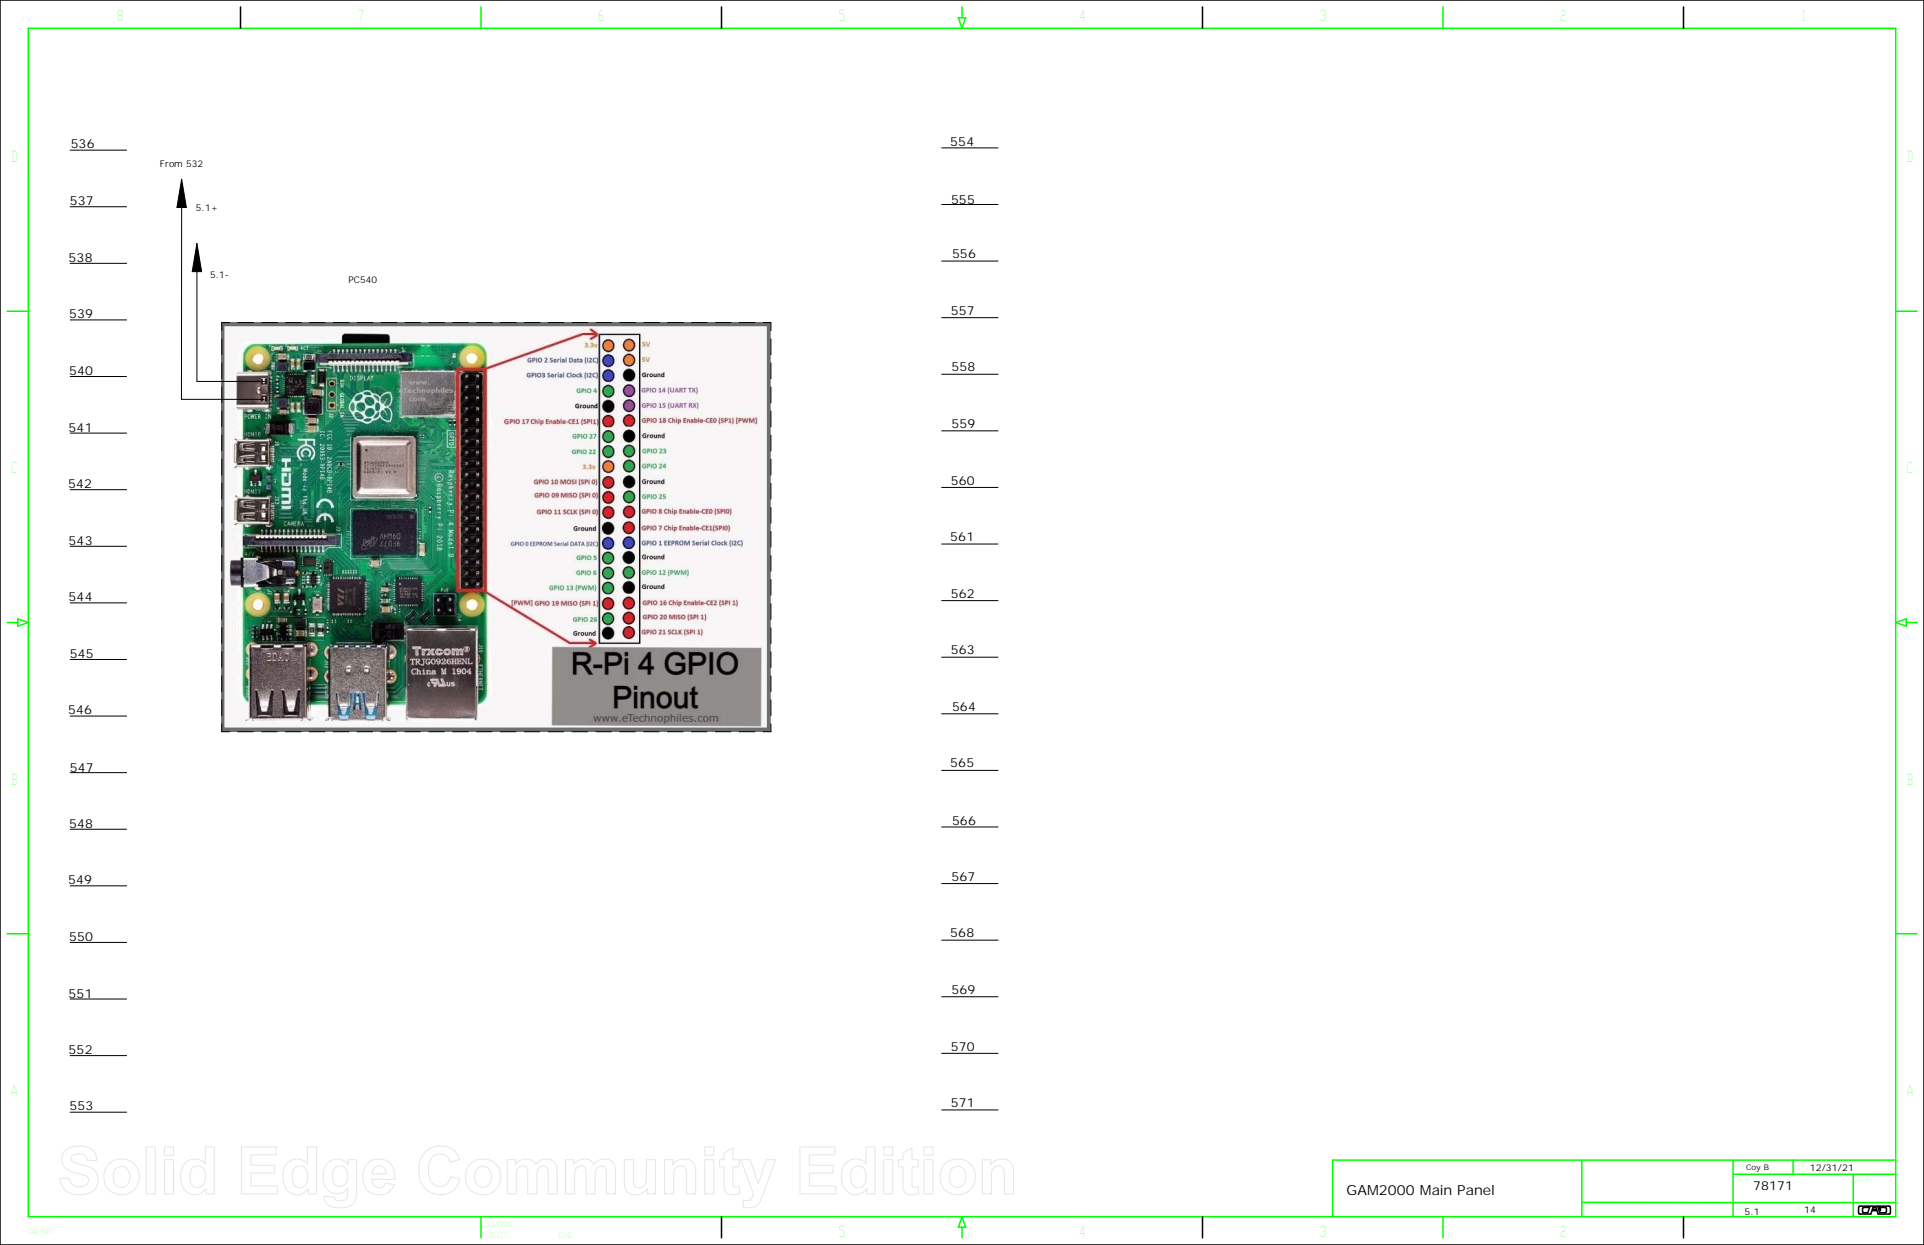
[picture p88: page 1]
CAD PART; SELECT:; ECHO:; LAYERING; From 532

GAM2000 Main Panel | | DWN Coy B | 12/31/21 DATE

Job NO 78171 | DWG REV

CUST | 14 SHEET 5.1 OF
