CoyBeard/Mirobot-Frame-Building-Cell/CAD/Gantry System/Machined Parts/2040x317 45degree  silver profile.pdf

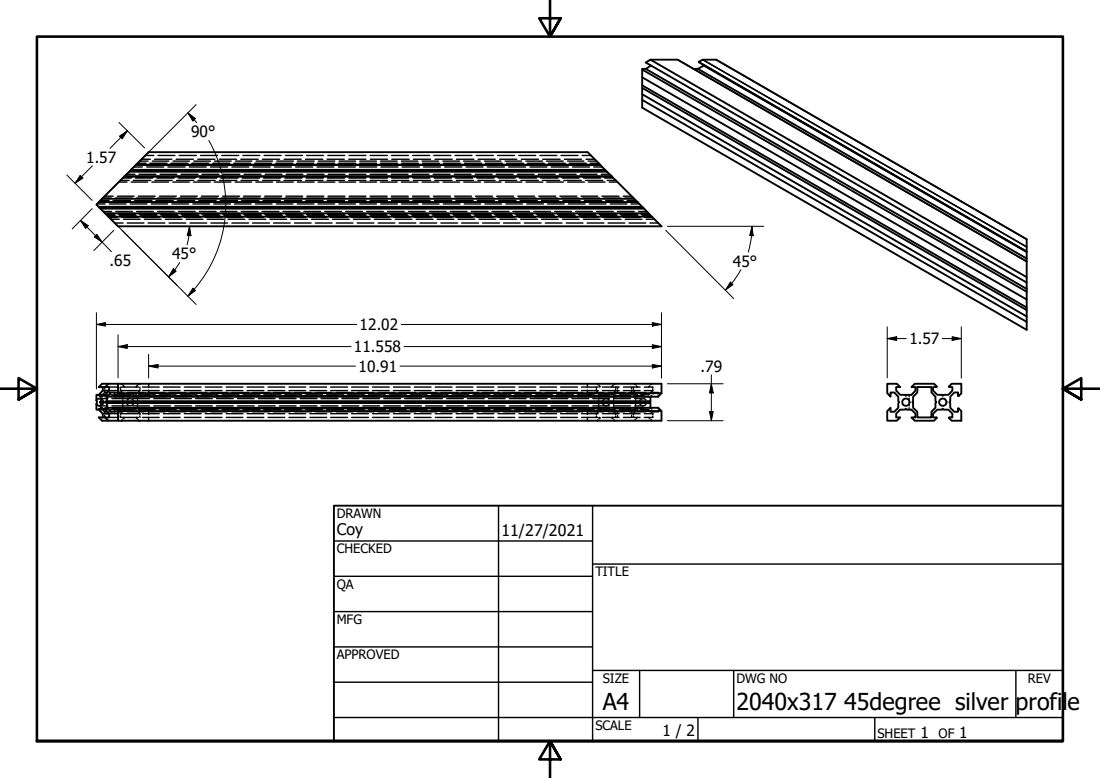
[picture p89: page 1]
2040x317 45degree silver; profile

DRAWN Coy | 11/27/2021

CHECKED

MFG

APPROVED

SIZE A4 | DWG NO | REV

SCALE 1 / 2 | | SHEET 1 OF 1
