CoyBeard/Mirobot-Frame-Building-Cell/CAD/Gantry System/Machined Parts/Generic 3x3 Corner Connecting Gusset.pdf

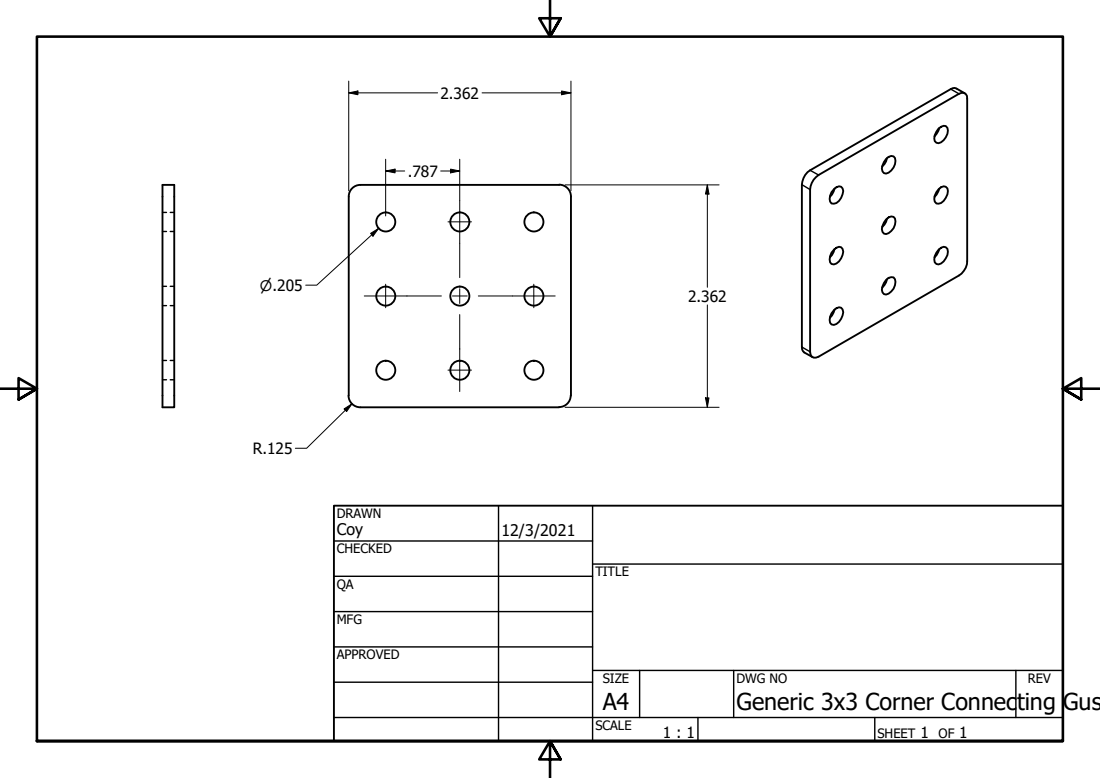
[picture p90: page 1]
Generic 3x3 Corner Connecting; Gus

DRAWN Coy | 12/3/2021

CHECKED

MFG

APPROVED

SIZE A4 | DWG NO | REV

SCALE 1 : 1 | | SHEET 1 OF 1
